yichengsun/Room-Mapping-Vehicle/CAD Files/3D Printing Schematics/encoder_hub.stl

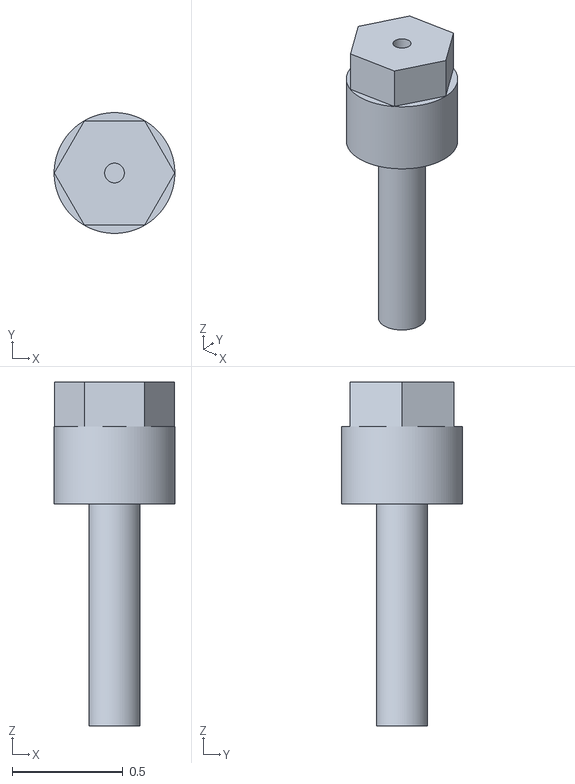
[picture p35: CAD file, 2015-08-05]
CAD Files/3D Printing Schematics/encoder_hub.stl
0.544 x 0.544 x 1.55
