yichengsun/Room-Mapping-Vehicle/CAD Files/Circuit Schematics/H_bridge.asc

A1: and
A2: and
A3: inv
M1: pmos
M2: pmos
M3: nmos
M4: nmos
R1: res; 6K
R2: res; 6K
U1: LT1017
U2: LT1017
Named nets: MOTOR+, MOTOR-, 7.2V, 0, 1.5V, PWM, DIR
