yichengsun/Room-Mapping-Vehicle/CAD Files/EAGLE Schematics/car.sch

## EAGLE design CAD Files/EAGLE Schematics/car.sch (2015-08-06)

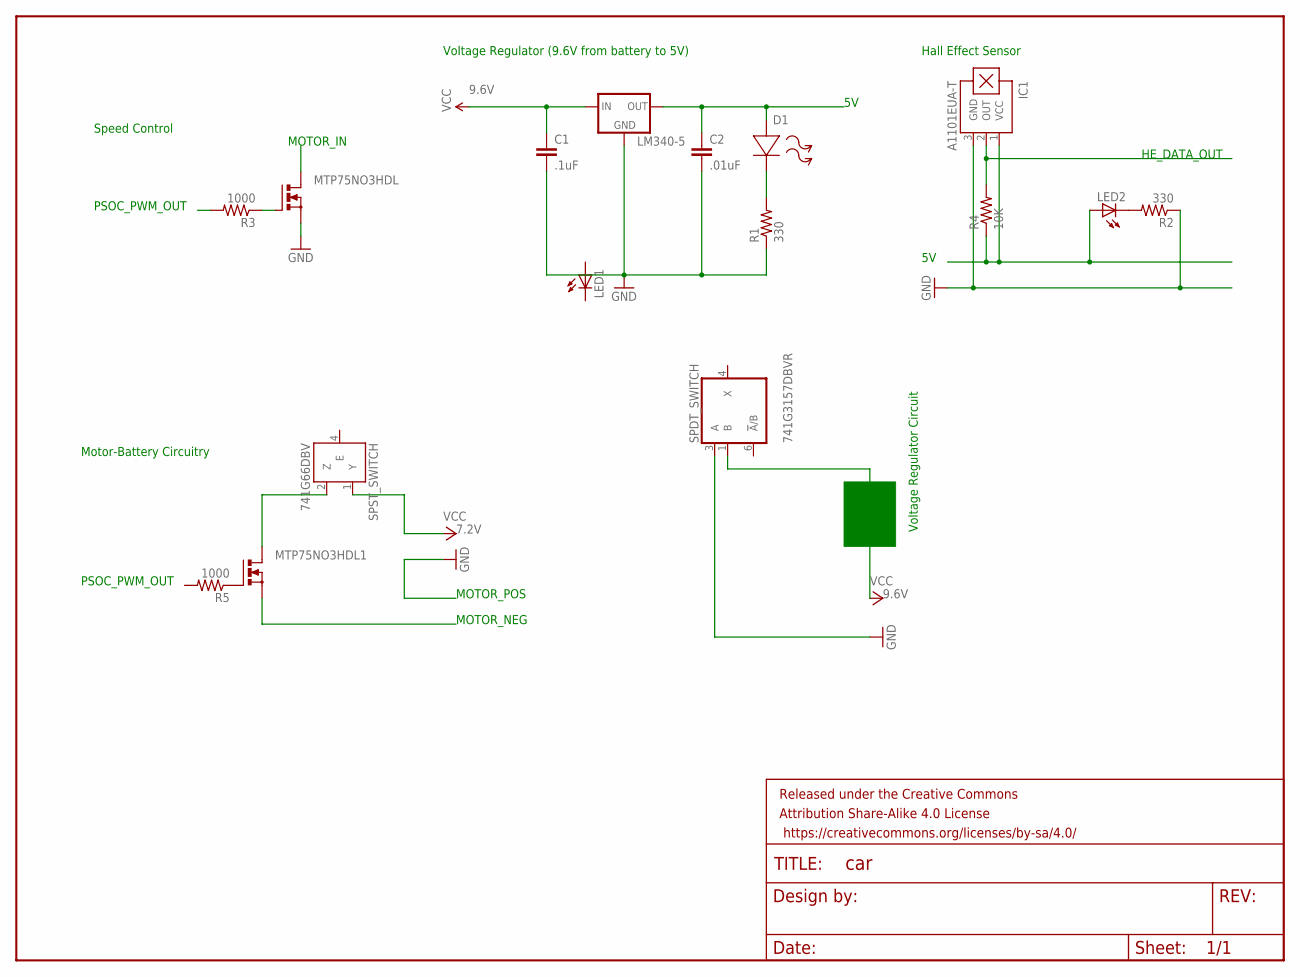
[picture p36: schematic car.sch]

Parts:
C1: .1uF; 0402-CAP
C2: .01uF; 0402-CAP
D1: LED; R0805
FRAME1: FRAME-LETTER; CREATIVE_COMMONS
IC1: A1101EUA-T; SOT23-W
LED1, LED2: LED_E; LED_1206
LM340-5: V_REG_78XX-TO-220; TO-220-ALT
MTP75NO3HDL, MTP75NO3HDL1: PMOSFET_NTO220BH; TO220BH
R1, R2: 330; 0402-RES
R3, R5: 1000; 0402-RES
R4: 10K; 0204V
SPDT_SWITCH: 741G3157DBVR; DBV_R-PDSO-G6
SPST_SWITCH: 741G66DBV; SOT23-5

Connections:
GND: C1.2, C2.2, IC1.3 (GND), LM340-5.GND, MTP75NO3HDL.S, R1.1, R2.1, SPDT_SWITCH.3 (A)
unnamed: IC1.1 (VCC), LED2.A, R4.1
unnamed: D1.2 (-), R1.2
unnamed: IC1.2 (OUT), R4.2
unnamed: C2.1, D1.1 (+), LM340-5.OUT
unnamed: LED2.C, R2.2
unnamed: MTP75NO3HDL.G, R3.1
unnamed: MTP75NO3HDL1.D, SPST_SWITCH.2 (Z)
unnamed: MTP75NO3HDL1.G, R5.1
VCC: C1.1, LM340-5.IN, SPST_SWITCH.1 (Y)

Notes on the sheet:
Voltage Regulator (9.6V from battery to 5V)
HE_DATA_OUT
Hall Effect Sensor
MOTOR_IN
PSOC_PWM_OUT
Speed Control
MOTOR_POS
MOTOR_NEG
Motor-Battery Circuitry
Voltage Regulator Circuit
