yichengsun/Room-Mapping-Vehicle/PSOC Microprocessor Code/Car.cydsn/codegentemp/MOTOR_PWM.c

/*******************************************************************************
* File Name: MOTOR_PWM.c
* Version 3.10
*
* Description:
*  The PWM User Module consist of an 8 or 16-bit counter with two 8 or 16-bit
*  comparitors. Each instance of this user module is capable of generating
*  two PWM outputs with the same period. The pulse width is selectable between
*  1 and 255/65535. The period is selectable between 2 and 255/65536 clocks.
*  The compare value output may be configured to be active when the present
*  counter is less than or less than/equal to the compare value.
*  A terminal count output is also provided. It generates a pulse one clock
*  width wide when the counter is equal to zero.
*
* Note:
*
*******************************************************************************
* Copyright 2008-2014, Cypress Semiconductor Corporation.  All rights reserved.
* You may use this file only in accordance with the license, terms, conditions,
* disclaimers, and limitations in the end user license agreement accompanying
* the software package with which this file was provided.
********************************************************************************/

#include "MOTOR_PWM.h"

/* Error message for removed <resource> through optimization */
#ifdef MOTOR_PWM_PWMUDB_genblk1_ctrlreg__REMOVED
    #error PWM_v3_10 detected with a constant 0 for the enable or \
         constant 1 for reset. This will prevent the component from operating.
#endif /* MOTOR_PWM_PWMUDB_genblk1_ctrlreg__REMOVED */

uint8 MOTOR_PWM_initVar = 0u;


/*******************************************************************************
* Function Name: MOTOR_PWM_Start
********************************************************************************
*
* Summary:
*  The start function initializes the pwm with the default values, the
*  enables the counter to begin counting.  It does not enable interrupts,
*  the EnableInt command should be called if interrupt generation is required.
*
* Parameters:
*  None
*
* Return:
*  None
*
* Global variables:
*  MOTOR_PWM_initVar: Is modified when this function is called for the
*   first time. Is used to ensure that initialization happens only once.
*
*******************************************************************************/
void MOTOR_PWM_Start(void) 
{
    /* If not Initialized then initialize all required hardware and software */
    if(MOTOR_PWM_initVar == 0u)
    {
        MOTOR_PWM_Init();
        MOTOR_PWM_initVar = 1u;
    }
    MOTOR_PWM_Enable();

}


/*******************************************************************************
* Function Name: MOTOR_PWM_Init
********************************************************************************
*
* Summary:
*  Initialize component's parameters to the parameters set by user in the
*  customizer of the component placed onto schematic. Usually called in
*  MOTOR_PWM_Start().
*
* Parameters:
*  None
*
* Return:
*  None
*
*******************************************************************************/
void MOTOR_PWM_Init(void) 
{
    #if (MOTOR_PWM_UsingFixedFunction || MOTOR_PWM_UseControl)
        uint8 ctrl;
    #endif /* (MOTOR_PWM_UsingFixedFunction || MOTOR_PWM_UseControl) */

    #if(!MOTOR_PWM_UsingFixedFunction)
        #if(MOTOR_PWM_UseStatus)
            /* Interrupt State Backup for Critical Region*/
            uint8 MOTOR_PWM_interruptState;
        #endif /* (MOTOR_PWM_UseStatus) */
    #endif /* (!MOTOR_PWM_UsingFixedFunction) */

    #if (MOTOR_PWM_UsingFixedFunction)
        /* You are allowed to write the compare value (FF only) */
        MOTOR_PWM_CONTROL |= MOTOR_PWM_CFG0_MODE;
        #if (MOTOR_PWM_DeadBand2_4)
            MOTOR_PWM_CONTROL |= MOTOR_PWM_CFG0_DB;
        #endif /* (MOTOR_PWM_DeadBand2_4) */

        ctrl = MOTOR_PWM_CONTROL3 & ((uint8 )(~MOTOR_PWM_CTRL_CMPMODE1_MASK));
        MOTOR_PWM_CONTROL3 = ctrl | MOTOR_PWM_DEFAULT_COMPARE1_MODE;

         /* Clear and Set SYNCTC and SYNCCMP bits of RT1 register */
        MOTOR_PWM_RT1 &= ((uint8)(~MOTOR_PWM_RT1_MASK));
        MOTOR_PWM_RT1 |= MOTOR_PWM_SYNC;

        /*Enable DSI Sync all all inputs of the PWM*/
        MOTOR_PWM_RT1 &= ((uint8)(~MOTOR_PWM_SYNCDSI_MASK));
        MOTOR_PWM_RT1 |= MOTOR_PWM_SYNCDSI_EN;

    #elif (MOTOR_PWM_UseControl)
        /* Set the default compare mode defined in the parameter */
        ctrl = MOTOR_PWM_CONTROL & ((uint8)(~MOTOR_PWM_CTRL_CMPMODE2_MASK)) &
                ((uint8)(~MOTOR_PWM_CTRL_CMPMODE1_MASK));
        MOTOR_PWM_CONTROL = ctrl | MOTOR_PWM_DEFAULT_COMPARE2_MODE |
                                   MOTOR_PWM_DEFAULT_COMPARE1_MODE;
    #endif /* (MOTOR_PWM_UsingFixedFunction) */

    #if (!MOTOR_PWM_UsingFixedFunction)
        #if (MOTOR_PWM_Resolution == 8)
            /* Set FIFO 0 to 1 byte register for period*/
            MOTOR_PWM_AUX_CONTROLDP0 |= (MOTOR_PWM_AUX_CTRL_FIFO0_CLR);
        #else /* (MOTOR_PWM_Resolution == 16)*/
            /* Set FIFO 0 to 1 byte register for period */
            MOTOR_PWM_AUX_CONTROLDP0 |= (MOTOR_PWM_AUX_CTRL_FIFO0_CLR);
            MOTOR_PWM_AUX_CONTROLDP1 |= (MOTOR_PWM_AUX_CTRL_FIFO0_CLR);
        #endif /* (MOTOR_PWM_Resolution == 8) */

        MOTOR_PWM_WriteCounter(MOTOR_PWM_INIT_PERIOD_VALUE);
    #endif /* (!MOTOR_PWM_UsingFixedFunction) */

    MOTOR_PWM_WritePeriod(MOTOR_PWM_INIT_PERIOD_VALUE);

        #if (MOTOR_PWM_UseOneCompareMode)
            MOTOR_PWM_WriteCompare(MOTOR_PWM_INIT_COMPARE_VALUE1);
        #else
            MOTOR_PWM_WriteCompare1(MOTOR_PWM_INIT_COMPARE_VALUE1);
            MOTOR_PWM_WriteCompare2(MOTOR_PWM_INIT_COMPARE_VALUE2);
        #endif /* (MOTOR_PWM_UseOneCompareMode) */

        #if (MOTOR_PWM_KillModeMinTime)
            MOTOR_PWM_WriteKillTime(MOTOR_PWM_MinimumKillTime);
        #endif /* (MOTOR_PWM_KillModeMinTime) */

        #if (MOTOR_PWM_DeadBandUsed)
            MOTOR_PWM_WriteDeadTime(MOTOR_PWM_INIT_DEAD_TIME);
        #endif /* (MOTOR_PWM_DeadBandUsed) */

    #if (MOTOR_PWM_UseStatus || MOTOR_PWM_UsingFixedFunction)
        MOTOR_PWM_SetInterruptMode(MOTOR_PWM_INIT_INTERRUPTS_MODE);
    #endif /* (MOTOR_PWM_UseStatus || MOTOR_PWM_UsingFixedFunction) */

    #if (MOTOR_PWM_UsingFixedFunction)
        /* Globally Enable the Fixed Function Block chosen */
        MOTOR_PWM_GLOBAL_ENABLE |= MOTOR_PWM_BLOCK_EN_MASK;
        /* Set the Interrupt source to come from the status register */
        MOTOR_PWM_CONTROL2 |= MOTOR_PWM_CTRL2_IRQ_SEL;
    #else
        #if(MOTOR_PWM_UseStatus)

            /* CyEnterCriticalRegion and CyExitCriticalRegion are used to mark following region critical*/
            /* Enter Critical Region*/
            MOTOR_PWM_interruptState = CyEnterCriticalSection();
            /* Use the interrupt output of the status register for IRQ output */
            MOTOR_PWM_STATUS_AUX_CTRL |= MOTOR_PWM_STATUS_ACTL_INT_EN_MASK;

             /* Exit Critical Region*/
            CyExitCriticalSection(MOTOR_PWM_interruptState);

            /* Clear the FIFO to enable the MOTOR_PWM_STATUS_FIFOFULL
                   bit to be set on FIFO full. */
            MOTOR_PWM_ClearFIFO();
        #endif /* (MOTOR_PWM_UseStatus) */
    #endif /* (MOTOR_PWM_UsingFixedFunction) */
}


/*******************************************************************************
* Function Name: MOTOR_PWM_Enable
********************************************************************************
*
* Summary:
*  Enables the PWM block operation
*
* Parameters:
*  None
*
* Return:
*  None
*
* Side Effects:
*  This works only if software enable mode is chosen
*
*******************************************************************************/
void MOTOR_PWM_Enable(void) 
{
    /* Globally Enable the Fixed Function Block chosen */
    #if (MOTOR_PWM_UsingFixedFunction)
        MOTOR_PWM_GLOBAL_ENABLE |= MOTOR_PWM_BLOCK_EN_MASK;
        MOTOR_PWM_GLOBAL_STBY_ENABLE |= MOTOR_PWM_BLOCK_STBY_EN_MASK;
    #endif /* (MOTOR_PWM_UsingFixedFunction) */

    /* Enable the PWM from the control register  */
    #if (MOTOR_PWM_UseControl || MOTOR_PWM_UsingFixedFunction)
        MOTOR_PWM_CONTROL |= MOTOR_PWM_CTRL_ENABLE;
    #endif /* (MOTOR_PWM_UseControl || MOTOR_PWM_UsingFixedFunction) */
}


/*******************************************************************************
* Function Name: MOTOR_PWM_Stop
********************************************************************************
*
* Summary:
*  The stop function halts the PWM, but does not change any modes or disable
*  interrupts.
*
* Parameters:
*  None
*
* Return:
*  None
*
* Side Effects:
*  If the Enable mode is set to Hardware only then this function
*  has no effect on the operation of the PWM
*
*******************************************************************************/
void MOTOR_PWM_Stop(void) 
{
    #if (MOTOR_PWM_UseControl || MOTOR_PWM_UsingFixedFunction)
        MOTOR_PWM_CONTROL &= ((uint8)(~MOTOR_PWM_CTRL_ENABLE));
    #endif /* (MOTOR_PWM_UseControl || MOTOR_PWM_UsingFixedFunction) */

    /* Globally disable the Fixed Function Block chosen */
    #if (MOTOR_PWM_UsingFixedFunction)
        MOTOR_PWM_GLOBAL_ENABLE &= ((uint8)(~MOTOR_PWM_BLOCK_EN_MASK));
        MOTOR_PWM_GLOBAL_STBY_ENABLE &= ((uint8)(~MOTOR_PWM_BLOCK_STBY_EN_MASK));
    #endif /* (MOTOR_PWM_UsingFixedFunction) */
}

#if (MOTOR_PWM_UseOneCompareMode)
    #if (MOTOR_PWM_CompareMode1SW)


        /*******************************************************************************
        * Function Name: MOTOR_PWM_SetCompareMode
        ********************************************************************************
        *
        * Summary:
        *  This function writes the Compare Mode for the pwm output when in Dither mode,
        *  Center Align Mode or One Output Mode.
        *
        * Parameters:
        *  comparemode:  The new compare mode for the PWM output. Use the compare types
        *                defined in the H file as input arguments.
        *
        * Return:
        *  None
        *
        *******************************************************************************/
        void MOTOR_PWM_SetCompareMode(uint8 comparemode) 
        {
            #if(MOTOR_PWM_UsingFixedFunction)

                #if(0 != MOTOR_PWM_CTRL_CMPMODE1_SHIFT)
                    uint8 comparemodemasked = ((uint8)((uint8)comparemode << MOTOR_PWM_CTRL_CMPMODE1_SHIFT));
                #else
                    uint8 comparemodemasked = comparemode;
                #endif /* (0 != MOTOR_PWM_CTRL_CMPMODE1_SHIFT) */

                MOTOR_PWM_CONTROL3 &= ((uint8)(~MOTOR_PWM_CTRL_CMPMODE1_MASK)); /*Clear Existing Data */
                MOTOR_PWM_CONTROL3 |= comparemodemasked;

            #elif (MOTOR_PWM_UseControl)

                #if(0 != MOTOR_PWM_CTRL_CMPMODE1_SHIFT)
                    uint8 comparemode1masked = ((uint8)((uint8)comparemode << MOTOR_PWM_CTRL_CMPMODE1_SHIFT)) &
                                                MOTOR_PWM_CTRL_CMPMODE1_MASK;
                #else
                    uint8 comparemode1masked = comparemode & MOTOR_PWM_CTRL_CMPMODE1_MASK;
                #endif /* (0 != MOTOR_PWM_CTRL_CMPMODE1_SHIFT) */

                #if(0 != MOTOR_PWM_CTRL_CMPMODE2_SHIFT)
                    uint8 comparemode2masked = ((uint8)((uint8)comparemode << MOTOR_PWM_CTRL_CMPMODE2_SHIFT)) &
                                               MOTOR_PWM_CTRL_CMPMODE2_MASK;
                #else
                    uint8 comparemode2masked = comparemode & MOTOR_PWM_CTRL_CMPMODE2_MASK;
                #endif /* (0 != MOTOR_PWM_CTRL_CMPMODE2_SHIFT) */

                /*Clear existing mode */
                MOTOR_PWM_CONTROL &= ((uint8)(~(MOTOR_PWM_CTRL_CMPMODE1_MASK |
                                            MOTOR_PWM_CTRL_CMPMODE2_MASK)));
                MOTOR_PWM_CONTROL |= (comparemode1masked | comparemode2masked);

            #else
                uint8 temp = comparemode;
            #endif /* (MOTOR_PWM_UsingFixedFunction) */
        }
    #endif /* MOTOR_PWM_CompareMode1SW */

#else /* UseOneCompareMode */

    #if (MOTOR_PWM_CompareMode1SW)


        /*******************************************************************************
        * Function Name: MOTOR_PWM_SetCompareMode1
        ********************************************************************************
        *
        * Summary:
        *  This function writes the Compare Mode for the pwm or pwm1 output
        *
        * Parameters:
        *  comparemode:  The new compare mode for the PWM output. Use the compare types
        *                defined in the H file as input arguments.
        *
        * Return:
        *  None
        *
        *******************************************************************************/
        void MOTOR_PWM_SetCompareMode1(uint8 comparemode) 
        {
            #if(0 != MOTOR_PWM_CTRL_CMPMODE1_SHIFT)
                uint8 comparemodemasked = ((uint8)((uint8)comparemode << MOTOR_PWM_CTRL_CMPMODE1_SHIFT)) &
                                           MOTOR_PWM_CTRL_CMPMODE1_MASK;
            #else
                uint8 comparemodemasked = comparemode & MOTOR_PWM_CTRL_CMPMODE1_MASK;
            #endif /* (0 != MOTOR_PWM_CTRL_CMPMODE1_SHIFT) */

            #if (MOTOR_PWM_UseControl)
                MOTOR_PWM_CONTROL &= ((uint8)(~MOTOR_PWM_CTRL_CMPMODE1_MASK)); /*Clear existing mode */
                MOTOR_PWM_CONTROL |= comparemodemasked;
            #endif /* (MOTOR_PWM_UseControl) */
        }
    #endif /* MOTOR_PWM_CompareMode1SW */

#if (MOTOR_PWM_CompareMode2SW)


    /*******************************************************************************
    * Function Name: MOTOR_PWM_SetCompareMode2
    ********************************************************************************
    *
    * Summary:
    *  This function writes the Compare Mode for the pwm or pwm2 output
    *
    * Parameters:
    *  comparemode:  The new compare mode for the PWM output. Use the compare types
    *                defined in the H file as input arguments.
    *
    * Return:
    *  None
    *
    *******************************************************************************/
    void MOTOR_PWM_SetCompareMode2(uint8 comparemode) 
    {

        #if(0 != MOTOR_PWM_CTRL_CMPMODE2_SHIFT)
            uint8 comparemodemasked = ((uint8)((uint8)comparemode << MOTOR_PWM_CTRL_CMPMODE2_SHIFT)) &
                                                 MOTOR_PWM_CTRL_CMPMODE2_MASK;
        #else
            uint8 comparemodemasked = comparemode & MOTOR_PWM_CTRL_CMPMODE2_MASK;
        #endif /* (0 != MOTOR_PWM_CTRL_CMPMODE2_SHIFT) */

        #if (MOTOR_PWM_UseControl)
            MOTOR_PWM_CONTROL &= ((uint8)(~MOTOR_PWM_CTRL_CMPMODE2_MASK)); /*Clear existing mode */
            MOTOR_PWM_CONTROL |= comparemodemasked;
        #endif /* (MOTOR_PWM_UseControl) */
    }
    #endif /*MOTOR_PWM_CompareMode2SW */

#endif /* UseOneCompareMode */


#if (!MOTOR_PWM_UsingFixedFunction)


    /*******************************************************************************
    * Function Name: MOTOR_PWM_WriteCounter
    ********************************************************************************
    *
    * Summary:
    *  Writes a new counter value directly to the counter register. This will be
    *  implemented for that currently running period and only that period. This API
    *  is valid only for UDB implementation and not available for fixed function
    *  PWM implementation.
    *
    * Parameters:
    *  counter:  The period new period counter value.
    *
    * Return:
    *  None
    *
    * Side Effects:
    *  The PWM Period will be reloaded when a counter value will be a zero
    *
    *******************************************************************************/
    void MOTOR_PWM_WriteCounter(uint16 counter) \
                                       
    {
        CY_SET_REG16(MOTOR_PWM_COUNTER_LSB_PTR, counter);
    }


    /*******************************************************************************
    * Function Name: MOTOR_PWM_ReadCounter
    ********************************************************************************
    *
    * Summary:
    *  This function returns the current value of the counter.  It doesn't matter
    *  if the counter is enabled or running.
    *
    * Parameters:
    *  None
    *
    * Return:
    *  The current value of the counter.
    *
    *******************************************************************************/
    uint16 MOTOR_PWM_ReadCounter(void) 
    {
        /* Force capture by reading Accumulator */
        /* Must first do a software capture to be able to read the counter */
        /* It is up to the user code to make sure there isn't already captured data in the FIFO */
          (void)CY_GET_REG8(MOTOR_PWM_COUNTERCAP_LSB_PTR_8BIT);

        /* Read the data from the FIFO */
        return (CY_GET_REG16(MOTOR_PWM_CAPTURE_LSB_PTR));
    }

    #if (MOTOR_PWM_UseStatus)


        /*******************************************************************************
        * Function Name: MOTOR_PWM_ClearFIFO
        ********************************************************************************
        *
        * Summary:
        *  This function clears all capture data from the capture FIFO
        *
        * Parameters:
        *  None
        *
        * Return:
        *  None
        *
        *******************************************************************************/
        void MOTOR_PWM_ClearFIFO(void) 
        {
            while(0u != (MOTOR_PWM_ReadStatusRegister() & MOTOR_PWM_STATUS_FIFONEMPTY))
            {
                (void)MOTOR_PWM_ReadCapture();
            }
        }

    #endif /* MOTOR_PWM_UseStatus */

#endif /* !MOTOR_PWM_UsingFixedFunction */


/*******************************************************************************
* Function Name: MOTOR_PWM_WritePeriod
********************************************************************************
*
* Summary:
*  This function is used to change the period of the counter.  The new period
*  will be loaded the next time terminal count is detected.
*
* Parameters:
*  period:  Period value. May be between 1 and (2^Resolution)-1.  A value of 0
*           will result in the counter remaining at zero.
*
* Return:
*  None
*
*******************************************************************************/
void MOTOR_PWM_WritePeriod(uint16 period) 
{
    #if(MOTOR_PWM_UsingFixedFunction)
        CY_SET_REG16(MOTOR_PWM_PERIOD_LSB_PTR, (uint16)period);
    #else
        CY_SET_REG16(MOTOR_PWM_PERIOD_LSB_PTR, period);
    #endif /* (MOTOR_PWM_UsingFixedFunction) */
}

#if (MOTOR_PWM_UseOneCompareMode)


    /*******************************************************************************
    * Function Name: MOTOR_PWM_WriteCompare
    ********************************************************************************
    *
    * Summary:
    *  This funtion is used to change the compare1 value when the PWM is in Dither
    *  mode. The compare output will reflect the new value on the next UDB clock.
    *  The compare output will be driven high when the present counter value is
    *  compared to the compare value based on the compare mode defined in
    *  Dither Mode.
    *
    * Parameters:
    *  compare:  New compare value.
    *
    * Return:
    *  None
    *
    * Side Effects:
    *  This function is only available if the PWM mode parameter is set to
    *  Dither Mode, Center Aligned Mode or One Output Mode
    *
    *******************************************************************************/
    void MOTOR_PWM_WriteCompare(uint16 compare) \
                                       
    {
        #if(MOTOR_PWM_UsingFixedFunction)
            CY_SET_REG16(MOTOR_PWM_COMPARE1_LSB_PTR, (uint16)compare);
        #else
            CY_SET_REG16(MOTOR_PWM_COMPARE1_LSB_PTR, compare);
        #endif /* (MOTOR_PWM_UsingFixedFunction) */

        #if (MOTOR_PWM_PWMMode == MOTOR_PWM__B_PWM__DITHER)
            #if(MOTOR_PWM_UsingFixedFunction)
                CY_SET_REG16(MOTOR_PWM_COMPARE2_LSB_PTR, (uint16)(compare + 1u));
            #else
                CY_SET_REG16(MOTOR_PWM_COMPARE2_LSB_PTR, (compare + 1u));
            #endif /* (MOTOR_PWM_UsingFixedFunction) */
        #endif /* (MOTOR_PWM_PWMMode == MOTOR_PWM__B_PWM__DITHER) */
    }


#else


    /*******************************************************************************
    * Function Name: MOTOR_PWM_WriteCompare1
    ********************************************************************************
    *
    * Summary:
    *  This funtion is used to change the compare1 value.  The compare output will
    *  reflect the new value on the next UDB clock.  The compare output will be
    *  driven high when the present counter value is less than or less than or
    *  equal to the compare register, depending on the mode.
    *
    * Parameters:
    *  compare:  New compare value.
    *
    * Return:
    *  None
    *
    *******************************************************************************/
    void MOTOR_PWM_WriteCompare1(uint16 compare) \
                                        
    {
        #if(MOTOR_PWM_UsingFixedFunction)
            CY_SET_REG16(MOTOR_PWM_COMPARE1_LSB_PTR, (uint16)compare);
        #else
            CY_SET_REG16(MOTOR_PWM_COMPARE1_LSB_PTR, compare);
        #endif /* (MOTOR_PWM_UsingFixedFunction) */
    }


    /*******************************************************************************
    * Function Name: MOTOR_PWM_WriteCompare2
    ********************************************************************************
    *
    * Summary:
    *  This funtion is used to change the compare value, for compare1 output.
    *  The compare output will reflect the new value on the next UDB clock.
    *  The compare output will be driven high when the present counter value is
    *  less than or less than or equal to the compare register, depending on the
    *  mode.
    *
    * Parameters:
    *  compare:  New compare value.
    *
    * Return:
    *  None
    *
    *******************************************************************************/
    void MOTOR_PWM_WriteCompare2(uint16 compare) \
                                        
    {
        #if(MOTOR_PWM_UsingFixedFunction)
            CY_SET_REG16(MOTOR_PWM_COMPARE2_LSB_PTR, compare);
        #else
            CY_SET_REG16(MOTOR_PWM_COMPARE2_LSB_PTR, compare);
        #endif /* (MOTOR_PWM_UsingFixedFunction) */
    }
#endif /* UseOneCompareMode */

#if (MOTOR_PWM_DeadBandUsed)


    /*******************************************************************************
    * Function Name: MOTOR_PWM_WriteDeadTime
    ********************************************************************************
    *
    * Summary:
    *  This function writes the dead-band counts to the corresponding register
    *
    * Parameters:
    *  deadtime:  Number of counts for dead time
    *
    * Return:
    *  None
    *
    *******************************************************************************/
    void MOTOR_PWM_WriteDeadTime(uint8 deadtime) 
    {
        /* If using the Dead Band 1-255 mode then just write the register */
        #if(!MOTOR_PWM_DeadBand2_4)
            CY_SET_REG8(MOTOR_PWM_DEADBAND_COUNT_PTR, deadtime);
        #else
            /* Otherwise the data has to be masked and offset */
            /* Clear existing data */
            MOTOR_PWM_DEADBAND_COUNT &= ((uint8)(~MOTOR_PWM_DEADBAND_COUNT_MASK));

            /* Set new dead time */
            #if(MOTOR_PWM_DEADBAND_COUNT_SHIFT)
                MOTOR_PWM_DEADBAND_COUNT |= ((uint8)((uint8)deadtime << MOTOR_PWM_DEADBAND_COUNT_SHIFT)) &
                                                    MOTOR_PWM_DEADBAND_COUNT_MASK;
            #else
                MOTOR_PWM_DEADBAND_COUNT |= deadtime & MOTOR_PWM_DEADBAND_COUNT_MASK;
            #endif /* (MOTOR_PWM_DEADBAND_COUNT_SHIFT) */

        #endif /* (!MOTOR_PWM_DeadBand2_4) */
    }


    /*******************************************************************************
    * Function Name: MOTOR_PWM_ReadDeadTime
    ********************************************************************************
    *
    * Summary:
    *  This function reads the dead-band counts from the corresponding register
    *
    * Parameters:
    *  None
    *
    * Return:
    *  Dead Band Counts
    *
    *******************************************************************************/
    uint8 MOTOR_PWM_ReadDeadTime(void) 
    {
        /* If using the Dead Band 1-255 mode then just read the register */
        #if(!MOTOR_PWM_DeadBand2_4)
            return (CY_GET_REG8(MOTOR_PWM_DEADBAND_COUNT_PTR));
        #else

            /* Otherwise the data has to be masked and offset */
            #if(MOTOR_PWM_DEADBAND_COUNT_SHIFT)
                return ((uint8)(((uint8)(MOTOR_PWM_DEADBAND_COUNT & MOTOR_PWM_DEADBAND_COUNT_MASK)) >>
                                                                           MOTOR_PWM_DEADBAND_COUNT_SHIFT));
            #else
                return (MOTOR_PWM_DEADBAND_COUNT & MOTOR_PWM_DEADBAND_COUNT_MASK);
            #endif /* (MOTOR_PWM_DEADBAND_COUNT_SHIFT) */
        #endif /* (!MOTOR_PWM_DeadBand2_4) */
    }
#endif /* DeadBandUsed */

#if (MOTOR_PWM_UseStatus || MOTOR_PWM_UsingFixedFunction)


    /*******************************************************************************
    * Function Name: MOTOR_PWM_SetInterruptMode
    ********************************************************************************
    *
    * Summary:
    *  This function configures the interrupts mask control of theinterrupt
    *  source status register.
    *
    * Parameters:
    *  uint8 interruptMode: Bit field containing the interrupt sources enabled
    *
    * Return:
    *  None
    *
    *******************************************************************************/
    void MOTOR_PWM_SetInterruptMode(uint8 interruptMode) 
    {
        CY_SET_REG8(MOTOR_PWM_STATUS_MASK_PTR, interruptMode);
    }


    /*******************************************************************************
    * Function Name: MOTOR_PWM_ReadStatusRegister
    ********************************************************************************
    *
    * Summary:
    *  This function returns the current state of the status register.
    *
    * Parameters:
    *  None
    *
    * Return:
    *  uint8 : Current status register value. The status register bits are:
    *  [7:6] : Unused(0)
    *  [5]   : Kill event output
    *  [4]   : FIFO not empty
    *  [3]   : FIFO full
    *  [2]   : Terminal count
    *  [1]   : Compare output 2
    *  [0]   : Compare output 1
    *
    *******************************************************************************/
    uint8 MOTOR_PWM_ReadStatusRegister(void) 
    {
        return (CY_GET_REG8(MOTOR_PWM_STATUS_PTR));
    }

#endif /* (MOTOR_PWM_UseStatus || MOTOR_PWM_UsingFixedFunction) */


#if (MOTOR_PWM_UseControl)


    /*******************************************************************************
    * Function Name: MOTOR_PWM_ReadControlRegister
    ********************************************************************************
    *
    * Summary:
    *  Returns the current state of the control register. This API is available
    *  only if the control register is not removed.
    *
    * Parameters:
    *  None
    *
    * Return:
    *  uint8 : Current control register value
    *
    *******************************************************************************/
    uint8 MOTOR_PWM_ReadControlRegister(void) 
    {
        uint8 result;

        result = CY_GET_REG8(MOTOR_PWM_CONTROL_PTR);
        return (result);
    }


    /*******************************************************************************
    * Function Name: MOTOR_PWM_WriteControlRegister
    ********************************************************************************
    *
    * Summary:
    *  Sets the bit field of the control register. This API is available only if
    *  the control register is not removed.
    *
    * Parameters:
    *  uint8 control: Control register bit field, The status register bits are:
    *  [7]   : PWM Enable
    *  [6]   : Reset
    *  [5:3] : Compare Mode2
    *  [2:0] : Compare Mode2
    *
    * Return:
    *  None
    *
    *******************************************************************************/
    void MOTOR_PWM_WriteControlRegister(uint8 control) 
    {
        CY_SET_REG8(MOTOR_PWM_CONTROL_PTR, control);
    }

#endif /* (MOTOR_PWM_UseControl) */


#if (!MOTOR_PWM_UsingFixedFunction)


    /*******************************************************************************
    * Function Name: MOTOR_PWM_ReadCapture
    ********************************************************************************
    *
    * Summary:
    *  Reads the capture value from the capture FIFO.
    *
    * Parameters:
    *  None
    *
    * Return:
    *  uint8/uint16: The current capture value
    *
    *******************************************************************************/
    uint16 MOTOR_PWM_ReadCapture(void) 
    {
        return (CY_GET_REG16(MOTOR_PWM_CAPTURE_LSB_PTR));
    }

#endif /* (!MOTOR_PWM_UsingFixedFunction) */


#if (MOTOR_PWM_UseOneCompareMode)


    /*******************************************************************************
    * Function Name: MOTOR_PWM_ReadCompare
    ********************************************************************************
    *
    * Summary:
    *  Reads the compare value for the compare output when the PWM Mode parameter is
    *  set to Dither mode, Center Aligned mode, or One Output mode.
    *
    * Parameters:
    *  None
    *
    * Return:
    *  uint8/uint16: Current compare value
    *
    *******************************************************************************/
    uint16 MOTOR_PWM_ReadCompare(void) 
    {
        #if(MOTOR_PWM_UsingFixedFunction)
            return ((uint16)CY_GET_REG16(MOTOR_PWM_COMPARE1_LSB_PTR));
        #else
            return (CY_GET_REG16(MOTOR_PWM_COMPARE1_LSB_PTR));
        #endif /* (MOTOR_PWM_UsingFixedFunction) */
    }

#else


    /*******************************************************************************
    * Function Name: MOTOR_PWM_ReadCompare1
    ********************************************************************************
    *
    * Summary:
    *  Reads the compare value for the compare1 output.
    *
    * Parameters:
    *  None
    *
    * Return:
    *  uint8/uint16: Current compare value.
    *
    *******************************************************************************/
    uint16 MOTOR_PWM_ReadCompare1(void) 
    {
        return (CY_GET_REG16(MOTOR_PWM_COMPARE1_LSB_PTR));
    }


    /*******************************************************************************
    * Function Name: MOTOR_PWM_ReadCompare2
    ********************************************************************************
    *
    * Summary:
    *  Reads the compare value for the compare2 output.
    *
    * Parameters:
    *  None
    *
    * Return:
    *  uint8/uint16: Current compare value.
    *
    *******************************************************************************/
    uint16 MOTOR_PWM_ReadCompare2(void) 
    {
        return (CY_GET_REG16(MOTOR_PWM_COMPARE2_LSB_PTR));
    }

#endif /* (MOTOR_PWM_UseOneCompareMode) */


/*******************************************************************************
* Function Name: MOTOR_PWM_ReadPeriod
********************************************************************************
*
* Summary:
*  Reads the period value used by the PWM hardware.
*
* Parameters:
*  None
*
* Return:
*  uint8/16: Period value
*
*******************************************************************************/
uint16 MOTOR_PWM_ReadPeriod(void) 
{
    #if(MOTOR_PWM_UsingFixedFunction)
        return ((uint16)CY_GET_REG16(MOTOR_PWM_PERIOD_LSB_PTR));
    #else
        return (CY_GET_REG16(MOTOR_PWM_PERIOD_LSB_PTR));
    #endif /* (MOTOR_PWM_UsingFixedFunction) */
}

#if ( MOTOR_PWM_KillModeMinTime)


    /*******************************************************************************
    * Function Name: MOTOR_PWM_WriteKillTime
    ********************************************************************************
    *
    * Summary:
    *  Writes the kill time value used by the hardware when the Kill Mode
    *  is set to Minimum Time.
    *
    * Parameters:
    *  uint8: Minimum Time kill counts
    *
    * Return:
    *  None
    *
    *******************************************************************************/
    void MOTOR_PWM_WriteKillTime(uint8 killtime) 
    {
        CY_SET_REG8(MOTOR_PWM_KILLMODEMINTIME_PTR, killtime);
    }


    /*******************************************************************************
    * Function Name: MOTOR_PWM_ReadKillTime
    ********************************************************************************
    *
    * Summary:
    *  Reads the kill time value used by the hardware when the Kill Mode is set
    *  to Minimum Time.
    *
    * Parameters:
    *  None
    *
    * Return:
    *  uint8: The current Minimum Time kill counts
    *
    *******************************************************************************/
    uint8 MOTOR_PWM_ReadKillTime(void) 
    {
        return (CY_GET_REG8(MOTOR_PWM_KILLMODEMINTIME_PTR));
    }

#endif /* ( MOTOR_PWM_KillModeMinTime) */

/* [] END OF FILE */
