yichengsun/Room-Mapping-Vehicle/PSOC Microprocessor Code/Car.cydsn/codegentemp/UPDATE_STEER_ISR.h

/*******************************************************************************
* File Name: UPDATE_STEER_ISR.h
* Version 1.70
*
*  Description:
*   Provides the function definitions for the Interrupt Controller.
*
*
********************************************************************************
* Copyright 2008-2012, Cypress Semiconductor Corporation.  All rights reserved.
* You may use this file only in accordance with the license, terms, conditions, 
* disclaimers, and limitations in the end user license agreement accompanying 
* the software package with which this file was provided.
*******************************************************************************/

#if !defined(CY_ISR_UPDATE_STEER_ISR_H)
#define CY_ISR_UPDATE_STEER_ISR_H

#include <cytypes.h>
#include <cyfitter.h>

/* Interrupt Controller API. */
void UPDATE_STEER_ISR_Start(void) ;
void UPDATE_STEER_ISR_StartEx(cyisraddress address) ;
void UPDATE_STEER_ISR_Stop(void) ;

CY_ISR_PROTO(UPDATE_STEER_ISR_Interrupt);

void UPDATE_STEER_ISR_SetVector(cyisraddress address) ;
cyisraddress UPDATE_STEER_ISR_GetVector(void) ;

void UPDATE_STEER_ISR_SetPriority(uint8 priority) ;
uint8 UPDATE_STEER_ISR_GetPriority(void) ;

void UPDATE_STEER_ISR_Enable(void) ;
uint8 UPDATE_STEER_ISR_GetState(void) ;
void UPDATE_STEER_ISR_Disable(void) ;

void UPDATE_STEER_ISR_SetPending(void) ;
void UPDATE_STEER_ISR_ClearPending(void) ;


/* Interrupt Controller Constants */

/* Address of the INTC.VECT[x] register that contains the Address of the UPDATE_STEER_ISR ISR. */
#define UPDATE_STEER_ISR_INTC_VECTOR            ((reg16 *) UPDATE_STEER_ISR__INTC_VECT)

/* Address of the UPDATE_STEER_ISR ISR priority. */
#define UPDATE_STEER_ISR_INTC_PRIOR             ((reg8 *) UPDATE_STEER_ISR__INTC_PRIOR_REG)

/* Priority of the UPDATE_STEER_ISR interrupt. */
#define UPDATE_STEER_ISR_INTC_PRIOR_NUMBER      UPDATE_STEER_ISR__INTC_PRIOR_NUM

/* Address of the INTC.SET_EN[x] byte to bit enable UPDATE_STEER_ISR interrupt. */
#define UPDATE_STEER_ISR_INTC_SET_EN            ((reg8 *) UPDATE_STEER_ISR__INTC_SET_EN_REG)

/* Address of the INTC.CLR_EN[x] register to bit clear the UPDATE_STEER_ISR interrupt. */
#define UPDATE_STEER_ISR_INTC_CLR_EN            ((reg8 *) UPDATE_STEER_ISR__INTC_CLR_EN_REG)

/* Address of the INTC.SET_PD[x] register to set the UPDATE_STEER_ISR interrupt state to pending. */
#define UPDATE_STEER_ISR_INTC_SET_PD            ((reg8 *) UPDATE_STEER_ISR__INTC_SET_PD_REG)

/* Address of the INTC.CLR_PD[x] register to clear the UPDATE_STEER_ISR interrupt. */
#define UPDATE_STEER_ISR_INTC_CLR_PD            ((reg8 *) UPDATE_STEER_ISR__INTC_CLR_PD_REG)



#endif /* CY_ISR_UPDATE_STEER_ISR_H */


/* [] END OF FILE */
