yichengsun/Room-Mapping-Vehicle/PSOC Microprocessor Code/Car.cydsn/codegentemp/LCD.h

/*******************************************************************************
* File Name: LCD.h
* Version 2.10
*
* Description:
*  This header file contains registers and constants associated with the
*  Character LCD component.
*
* Note:
*
********************************************************************************
* Copyright 2008-2014, Cypress Semiconductor Corporation.  All rights reserved.
* You may use this file only in accordance with the license, terms, conditions,
* disclaimers, and limitations in the end user license agreement accompanying
* the software package with which this file was provided.
*******************************************************************************/

#if !defined(CY_CHARLCD_LCD_H)
#define CY_CHARLCD_LCD_H

#include "cytypes.h"
#include "cyfitter.h"


/***************************************
*   Conditional Compilation Parameters
***************************************/

#define LCD_CONVERSION_ROUTINES     (1u)
#define LCD_CUSTOM_CHAR_SET         (0u)

/* Custom character set types */
#define LCD_NONE                     (0u)    /* No Custom Fonts      */
#define LCD_HORIZONTAL_BG            (1u)    /* Horizontal Bar Graph */
#define LCD_VERTICAL_BG              (2u)    /* Vertical Bar Graph   */
#define LCD_USER_DEFINED             (3u)    /* User Defined Fonts   */


/***************************************
*     Data Struct Definitions
***************************************/

/* Sleep Mode API Support */
typedef struct
{
    uint8 enableState;
} LCD_BACKUP_STRUCT;


/***************************************
*        Function Prototypes
***************************************/

void LCD_Init(void) ;
void LCD_Enable(void) ;
void LCD_Start(void) ;
void LCD_Stop(void) ;
void LCD_WriteControl(uint8 cByte) ;
void LCD_WriteData(uint8 dByte) ;
void LCD_PrintString(char8 const string[]) ;
void LCD_Position(uint8 row, uint8 column) ;
void LCD_PutChar(char8 character) ;
void LCD_IsReady(void) ;
void LCD_SaveConfig(void) ;
void LCD_RestoreConfig(void) ;
void LCD_Sleep(void) ;
void LCD_Wakeup(void) ;

#if((LCD_CUSTOM_CHAR_SET == LCD_VERTICAL_BG) || \
                (LCD_CUSTOM_CHAR_SET == LCD_HORIZONTAL_BG))

    void  LCD_LoadCustomFonts(uint8 const customData[])
                        ;

    void  LCD_DrawHorizontalBG(uint8 row, uint8 column, uint8 maxCharacters, uint8 value)
                         ;

    void LCD_DrawVerticalBG(uint8 row, uint8 column, uint8 maxCharacters, uint8 value)
                        ;

#endif /* ((LCD_CUSTOM_CHAR_SET == LCD_VERTICAL_BG) */

#if(LCD_CUSTOM_CHAR_SET == LCD_USER_DEFINED)

    void LCD_LoadCustomFonts(uint8 const customData[])
                            ;

#endif /* ((LCD_CUSTOM_CHAR_SET == LCD_USER_DEFINED) */

#if(LCD_CONVERSION_ROUTINES == 1u)

    /* ASCII Conversion Routines */
    void LCD_PrintInt8(uint8 value) ;
    void LCD_PrintInt16(uint16 value) ;
    void LCD_PrintInt32(uint32 value) ;
    void LCD_PrintNumber(uint16 value) ; 
    void LCD_PrintU32Number(uint32 value) ;
    
#endif /* LCD_CONVERSION_ROUTINES == 1u */

/* Clear Macro */
#define LCD_ClearDisplay() LCD_WriteControl(LCD_CLEAR_DISPLAY)

/* Off Macro */
#define LCD_DisplayOff() LCD_WriteControl(LCD_DISPLAY_CURSOR_OFF)

/* On Macro */
#define LCD_DisplayOn() LCD_WriteControl(LCD_DISPLAY_ON_CURSOR_OFF)

#define LCD_PrintNumber(value) LCD_PrintU32Number((uint16) (value))


/***************************************
*           Global Variables
***************************************/

extern uint8 LCD_initVar;
extern uint8 LCD_enableState;
extern uint8 const CYCODE LCD_customFonts[64u];


/***************************************
*           API Constants
***************************************/

/* Full Byte Commands Sent as Two Nibbles */
#define LCD_DISPLAY_8_BIT_INIT       (0x03u)
#define LCD_DISPLAY_4_BIT_INIT       (0x02u)
#define LCD_DISPLAY_CURSOR_OFF       (0x08u)
#define LCD_CLEAR_DISPLAY            (0x01u)
#define LCD_CURSOR_AUTO_INCR_ON      (0x06u)
#define LCD_DISPLAY_CURSOR_ON        (0x0Eu)
#define LCD_DISPLAY_2_LINES_5x10     (0x2Cu)
#define LCD_DISPLAY_ON_CURSOR_OFF    (0x0Cu)

#define LCD_RESET_CURSOR_POSITION    (0x03u)
#define LCD_CURSOR_WINK              (0x0Du)
#define LCD_CURSOR_BLINK             (0x0Fu)
#define LCD_CURSOR_SH_LEFT           (0x10u)
#define LCD_CURSOR_SH_RIGHT          (0x14u)
#define LCD_DISPLAY_SCRL_LEFT        (0x18u)
#define LCD_DISPLAY_SCRL_RIGHT       (0x1Eu)
#define LCD_CURSOR_HOME              (0x02u)
#define LCD_CURSOR_LEFT              (0x04u)
#define LCD_CURSOR_RIGHT             (0x06u)

/* Point to Character Generator Ram 0 */
#define LCD_CGRAM_0                  (0x40u)

/* Point to Display Data Ram 0 */
#define LCD_DDRAM_0                  (0x80u)

/* LCD Characteristics */
#define LCD_CHARACTER_WIDTH          (0x05u)
#define LCD_CHARACTER_HEIGHT         (0x08u)

#if(LCD_CONVERSION_ROUTINES == 1u)
    #define LCD_NUMBER_OF_REMAINDERS_U32 (0x0Au)
    #define LCD_TEN                      (0x0Au)
    #define LCD_8_BIT_SHIFT              (8u)
    #define LCD_32_BIT_SHIFT             (32u)
    #define LCD_ZERO_CHAR_ASCII          (48u)
#endif /* LCD_CONVERSION_ROUTINES == 1u */

/* Nibble Offset and Mask */
#define LCD_NIBBLE_SHIFT             (0x04u)
#define LCD_NIBBLE_MASK              (0x0Fu)

/* LCD Module Address Constants */
#define LCD_ROW_0_START              (0x80u)
#define LCD_ROW_1_START              (0xC0u)
#define LCD_ROW_2_START              (0x94u)
#define LCD_ROW_3_START              (0xD4u)

/* Custom Character References */
#define LCD_CUSTOM_0                 (0x00u)
#define LCD_CUSTOM_1                 (0x01u)
#define LCD_CUSTOM_2                 (0x02u)
#define LCD_CUSTOM_3                 (0x03u)
#define LCD_CUSTOM_4                 (0x04u)
#define LCD_CUSTOM_5                 (0x05u)
#define LCD_CUSTOM_6                 (0x06u)
#define LCD_CUSTOM_7                 (0x07u)

/* Other constants */
#define LCD_BYTE_UPPER_NIBBLE_SHIFT  (0x04u)
#define LCD_BYTE_LOWER_NIBBLE_MASK   (0x0Fu)
#define LCD_U16_UPPER_BYTE_SHIFT     (0x08u)
#define LCD_U16_LOWER_BYTE_MASK      (0xFFu)
#define LCD_CUSTOM_CHAR_SET_LEN      (0x40u)

#define LCD_LONGEST_CMD_US           (0x651u)
#define LCD_WAIT_CYCLE               (0x10u)
#define LCD_READY_DELAY              ((LCD_LONGEST_CMD_US * 4u)/(LCD_WAIT_CYCLE))


/***************************************
*             Registers
***************************************/

/* Device specific registers */
#if (CY_PSOC4)

    #define LCD_PORT_DR_REG           (*(reg32 *) LCD_LCDPort__DR)  /* Data Output Register */
    #define LCD_PORT_DR_PTR           ( (reg32 *) LCD_LCDPort__DR)
    #define LCD_PORT_PS_REG           (*(reg32 *) LCD_LCDPort__PS)  /* Pin State Register */
    #define LCD_PORT_PS_PTR           ( (reg32 *) LCD_LCDPort__PS)
    
    #define LCD_PORT_PC_REG           (*(reg32 *) LCD_LCDPort__PC)
    #define LCD_PORT_PC_PTR           (*(reg32 *) LCD_LCDPort__PC)
    
#else

    #define LCD_PORT_DR_REG           (*(reg8 *) LCD_LCDPort__DR)  /* Data Output Register */
    #define LCD_PORT_DR_PTR           ( (reg8 *) LCD_LCDPort__DR)
    #define LCD_PORT_PS_REG           (*(reg8 *) LCD_LCDPort__PS)  /* Pin State Register */
    #define LCD_PORT_PS_PTR           ( (reg8 *) LCD_LCDPort__PS)

    #define LCD_PORT_DM0_REG          (*(reg8 *) LCD_LCDPort__DM0) /* Port Drive Mode 0 */
    #define LCD_PORT_DM0_PTR          ( (reg8 *) LCD_LCDPort__DM0)
    #define LCD_PORT_DM1_REG          (*(reg8 *) LCD_LCDPort__DM1) /* Port Drive Mode 1 */
    #define LCD_PORT_DM1_PTR          ( (reg8 *) LCD_LCDPort__DM1)
    #define LCD_PORT_DM2_REG          (*(reg8 *) LCD_LCDPort__DM2) /* Port Drive Mode 2 */
    #define LCD_PORT_DM2_PTR          ( (reg8 *) LCD_LCDPort__DM2)

#endif /* CY_PSOC4 */


/***************************************
*       Register Constants
***************************************/

/* SHIFT must be 1 or 0 */
#if (0 == LCD_LCDPort__SHIFT)
    #define LCD_PORT_SHIFT               (0x00u)
#else
    #define LCD_PORT_SHIFT               (0x01u)
#endif /* (0 == LCD_LCDPort__SHIFT) */

#define LCD_PORT_MASK                ((uint8) (LCD_LCDPort__MASK))

#if (CY_PSOC4)

    #define LCD_DM_PIN_STEP              (3u)
    /* Hi-Z Digital is defined by the value of "001b" and this should be set for
    * four data pins, in this way we get - 0x00000249. A similar Strong drive
    * is defined with "110b" so we get 0x00000DB6.
    */
    #define LCD_HIGH_Z_DATA_DM           ((0x00000249ul) << (LCD_PORT_SHIFT *\
                                                                          LCD_DM_PIN_STEP))
    #define LCD_STRONG_DATA_DM           ((0x00000DB6ul) << (LCD_PORT_SHIFT *\
                                                                          LCD_DM_PIN_STEP))
    #define LCD_DATA_PINS_MASK           (0x00000FFFul)
    #define LCD_DM_DATA_MASK             ((uint32) (LCD_DATA_PINS_MASK << \
                                                      (LCD_PORT_SHIFT * LCD_DM_PIN_STEP)))

#else

    /* Drive Mode register values for High Z */
    #define LCD_HIGH_Z_DM0               (0xFFu)
    #define LCD_HIGH_Z_DM1               (0x00u)
    #define LCD_HIGH_Z_DM2               (0x00u)

    /* Drive Mode register values for High Z Analog */
    #define LCD_HIGH_Z_A_DM0             (0x00u)
    #define LCD_HIGH_Z_A_DM1             (0x00u)
    #define LCD_HIGH_Z_A_DM2             (0x00u)

    /* Drive Mode register values for Strong */
    #define LCD_STRONG_DM0               (0x00u)
    #define LCD_STRONG_DM1               (0xFFu)
    #define LCD_STRONG_DM2               (0xFFu)

#endif /* CY_PSOC4 */

/* Pin Masks */
#define LCD_RS                     ((uint8) \
                                                (((uint8) 0x20u) << LCD_LCDPort__SHIFT))
#define LCD_RW                     ((uint8) \
                                                (((uint8) 0x40u) << LCD_LCDPort__SHIFT))
#define LCD_E                      ((uint8) \
                                                (((uint8) 0x10u) << LCD_LCDPort__SHIFT))
#define LCD_READY_BIT              ((uint8) \
                                                (((uint8) 0x08u) << LCD_LCDPort__SHIFT))
#define LCD_DATA_MASK              ((uint8) \
                                                (((uint8) 0x0Fu) << LCD_LCDPort__SHIFT))

/* These names are obsolete and will be removed in future revisions */
#define LCD_PORT_DR                  LCD_PORT_DR_REG
#define LCD_PORT_PS                  LCD_PORT_PS_REG
#define LCD_PORT_DM0                 LCD_PORT_DM0_REG
#define LCD_PORT_DM1                 LCD_PORT_DM1_REG
#define LCD_PORT_DM2                 LCD_PORT_DM2_REG


/***************************************
*       Obsolete function names
***************************************/
#if(LCD_CONVERSION_ROUTINES == 1u)
    /* This function names are obsolete and will be removed in future 
    * revisions of the component.
    */
    #define LCD_PrintDecUint16(x)   LCD_PrintNumber(x)  
    #define LCD_PrintHexUint8(x)    LCD_PrintInt8(x)
    #define LCD_PrintHexUint16(x)   LCD_PrintInt16(x)        

#endif /* LCD_CONVERSION_ROUTINES == 1u */

#endif /* CY_CHARLCD_LCD_H */


/* [] END OF FILE */
