yichengsun/Room-Mapping-Vehicle/PSOC Microprocessor Code/Car.cydsn/codegentemp/LINE_COUNTER.h

/*******************************************************************************
* File Name: LINE_COUNTER.h  
* Version 2.40
*
*  Description:
*   Contains the function prototypes and constants available to the counter
*   user module.
*
*   Note:
*    None
*
********************************************************************************
* Copyright 2008-2012, Cypress Semiconductor Corporation.  All rights reserved.
* You may use this file only in accordance with the license, terms, conditions, 
* disclaimers, and limitations in the end user license agreement accompanying 
* the software package with which this file was provided.
********************************************************************************/
    
#if !defined(CY_COUNTER_LINE_COUNTER_H)
#define CY_COUNTER_LINE_COUNTER_H

#include "cytypes.h"
#include "cyfitter.h"
#include "CyLib.h" /* For CyEnterCriticalSection() and CyExitCriticalSection() functions */

extern uint8 LINE_COUNTER_initVar;

/* Check to see if required defines such as CY_PSOC5LP are available */
/* They are defined starting with cy_boot v3.0 */
#if !defined (CY_PSOC5LP)
    #error Component Counter_v2_40 requires cy_boot v3.0 or later
#endif /* (CY_ PSOC5LP) */


/**************************************
*           Parameter Defaults        
**************************************/

#define LINE_COUNTER_Resolution            32u
#define LINE_COUNTER_UsingFixedFunction    0u
#define LINE_COUNTER_ControlRegRemoved     0u
#define LINE_COUNTER_COMPARE_MODE_SOFTWARE 0u
#define LINE_COUNTER_CAPTURE_MODE_SOFTWARE 0u
#define LINE_COUNTER_RunModeUsed           0u


/***************************************
*       Type defines
***************************************/


/**************************************************************************
 * Sleep Mode API Support
 * Backup structure for Sleep Wake up operations
 *************************************************************************/
typedef struct
{
    uint8 CounterEnableState; 
    uint32 CounterUdb;         /* Current Counter Value */

    #if (CY_UDB_V0)
        uint32 CounterPeriod;  /* Counter Period Value */
        uint32 CompareValue;   /* Counter Compare Value */           
        uint8 InterruptMaskValue;                   /* Counter Interrupt Mask Value */
    #endif /* (CY_UDB_V0) */

    #if (!LINE_COUNTER_ControlRegRemoved)
        uint8 CounterControlRegister;               /* Counter Control Register */
    #endif /* (!LINE_COUNTER_ControlRegRemoved) */

}LINE_COUNTER_backupStruct;


/**************************************
 *  Function Prototypes
 *************************************/
void    LINE_COUNTER_Start(void) ;
void    LINE_COUNTER_Stop(void) ;
void    LINE_COUNTER_SetInterruptMode(uint8 interruptsMask) ;
uint8   LINE_COUNTER_ReadStatusRegister(void) ;
#define LINE_COUNTER_GetInterruptSource() LINE_COUNTER_ReadStatusRegister()
#if(!LINE_COUNTER_ControlRegRemoved)
    uint8   LINE_COUNTER_ReadControlRegister(void) ;
    void    LINE_COUNTER_WriteControlRegister(uint8 control) \
        ;
#endif /* (!LINE_COUNTER_ControlRegRemoved) */
#if (!(LINE_COUNTER_UsingFixedFunction && (CY_PSOC5A)))
    void    LINE_COUNTER_WriteCounter(uint32 counter) \
            ; 
#endif /* (!(LINE_COUNTER_UsingFixedFunction && (CY_PSOC5A))) */
uint32  LINE_COUNTER_ReadCounter(void) ;
uint32  LINE_COUNTER_ReadCapture(void) ;
void    LINE_COUNTER_WritePeriod(uint32 period) \
    ;
uint32  LINE_COUNTER_ReadPeriod( void ) ;
#if (!LINE_COUNTER_UsingFixedFunction)
    void    LINE_COUNTER_WriteCompare(uint32 compare) \
        ;
    uint32  LINE_COUNTER_ReadCompare( void ) \
        ;
#endif /* (!LINE_COUNTER_UsingFixedFunction) */

#if (LINE_COUNTER_COMPARE_MODE_SOFTWARE)
    void    LINE_COUNTER_SetCompareMode(uint8 compareMode) ;
#endif /* (LINE_COUNTER_COMPARE_MODE_SOFTWARE) */
#if (LINE_COUNTER_CAPTURE_MODE_SOFTWARE)
    void    LINE_COUNTER_SetCaptureMode(uint8 captureMode) ;
#endif /* (LINE_COUNTER_CAPTURE_MODE_SOFTWARE) */
void LINE_COUNTER_ClearFIFO(void)     ;
void LINE_COUNTER_Init(void)          ;
void LINE_COUNTER_Enable(void)        ;
void LINE_COUNTER_SaveConfig(void)    ;
void LINE_COUNTER_RestoreConfig(void) ;
void LINE_COUNTER_Sleep(void)         ;
void LINE_COUNTER_Wakeup(void)        ;


/***************************************
*   Enumerated Types and Parameters
***************************************/

/* Enumerated Type B_Counter__CompareModes, Used in Compare Mode retained for backward compatibility of tests*/
#define LINE_COUNTER__B_COUNTER__LESS_THAN 1
#define LINE_COUNTER__B_COUNTER__LESS_THAN_OR_EQUAL 2
#define LINE_COUNTER__B_COUNTER__EQUAL 0
#define LINE_COUNTER__B_COUNTER__GREATER_THAN 3
#define LINE_COUNTER__B_COUNTER__GREATER_THAN_OR_EQUAL 4
#define LINE_COUNTER__B_COUNTER__SOFTWARE 5

/* Enumerated Type Counter_CompareModes */
#define LINE_COUNTER_CMP_MODE_LT 1u
#define LINE_COUNTER_CMP_MODE_LTE 2u
#define LINE_COUNTER_CMP_MODE_EQ 0u
#define LINE_COUNTER_CMP_MODE_GT 3u
#define LINE_COUNTER_CMP_MODE_GTE 4u
#define LINE_COUNTER_CMP_MODE_SOFTWARE_CONTROLLED 5u

/* Enumerated Type B_Counter__CaptureModes, Used in Capture Mode retained for backward compatibility of tests*/
#define LINE_COUNTER__B_COUNTER__NONE 0
#define LINE_COUNTER__B_COUNTER__RISING_EDGE 1
#define LINE_COUNTER__B_COUNTER__FALLING_EDGE 2
#define LINE_COUNTER__B_COUNTER__EITHER_EDGE 3
#define LINE_COUNTER__B_COUNTER__SOFTWARE_CONTROL 4

/* Enumerated Type Counter_CompareModes */
#define LINE_COUNTER_CAP_MODE_NONE 0u
#define LINE_COUNTER_CAP_MODE_RISE 1u
#define LINE_COUNTER_CAP_MODE_FALL 2u
#define LINE_COUNTER_CAP_MODE_BOTH 3u
#define LINE_COUNTER_CAP_MODE_SOFTWARE_CONTROLLED 4u


/***************************************
 *  Initialization Values
 **************************************/
#define LINE_COUNTER_CAPTURE_MODE_CONF       0u
#define LINE_COUNTER_INIT_PERIOD_VALUE       4294967295u
#define LINE_COUNTER_INIT_COUNTER_VALUE      0u
#if (LINE_COUNTER_UsingFixedFunction)
#define LINE_COUNTER_INIT_INTERRUPTS_MASK    ((uint8)((uint8)0u << LINE_COUNTER_STATUS_ZERO_INT_EN_MASK_SHIFT))
#else
#define LINE_COUNTER_INIT_COMPARE_VALUE      25u
#define LINE_COUNTER_INIT_INTERRUPTS_MASK ((uint8)((uint8)0u << LINE_COUNTER_STATUS_ZERO_INT_EN_MASK_SHIFT) | \
        ((uint8)((uint8)0u << LINE_COUNTER_STATUS_CAPTURE_INT_EN_MASK_SHIFT)) | \
        ((uint8)((uint8)0u << LINE_COUNTER_STATUS_CMP_INT_EN_MASK_SHIFT)) | \
        ((uint8)((uint8)0u << LINE_COUNTER_STATUS_OVERFLOW_INT_EN_MASK_SHIFT)) | \
        ((uint8)((uint8)0u << LINE_COUNTER_STATUS_UNDERFLOW_INT_EN_MASK_SHIFT)))
#define LINE_COUNTER_DEFAULT_COMPARE_MODE    0u

#if( 0 != LINE_COUNTER_CAPTURE_MODE_CONF)
    #define LINE_COUNTER_DEFAULT_CAPTURE_MODE    ((uint8)((uint8)0u << LINE_COUNTER_CTRL_CAPMODE0_SHIFT))
#else    
    #define LINE_COUNTER_DEFAULT_CAPTURE_MODE    (0u )
#endif /* ( 0 != LINE_COUNTER_CAPTURE_MODE_CONF) */

#endif /* (LINE_COUNTER_UsingFixedFunction) */


/**************************************
 *  Registers
 *************************************/
#if (LINE_COUNTER_UsingFixedFunction)
    #define LINE_COUNTER_STATICCOUNT_LSB     (*(reg16 *) LINE_COUNTER_CounterHW__CAP0 )
    #define LINE_COUNTER_STATICCOUNT_LSB_PTR ( (reg16 *) LINE_COUNTER_CounterHW__CAP0 )
    #define LINE_COUNTER_PERIOD_LSB          (*(reg16 *) LINE_COUNTER_CounterHW__PER0 )
    #define LINE_COUNTER_PERIOD_LSB_PTR      ( (reg16 *) LINE_COUNTER_CounterHW__PER0 )
    /* MODE must be set to 1 to set the compare value */
    #define LINE_COUNTER_COMPARE_LSB         (*(reg16 *) LINE_COUNTER_CounterHW__CNT_CMP0 )
    #define LINE_COUNTER_COMPARE_LSB_PTR     ( (reg16 *) LINE_COUNTER_CounterHW__CNT_CMP0 )
    /* MODE must be set to 0 to get the count */
    #define LINE_COUNTER_COUNTER_LSB         (*(reg16 *) LINE_COUNTER_CounterHW__CNT_CMP0 )
    #define LINE_COUNTER_COUNTER_LSB_PTR     ( (reg16 *) LINE_COUNTER_CounterHW__CNT_CMP0 )
    #define LINE_COUNTER_RT1                 (*(reg8 *) LINE_COUNTER_CounterHW__RT1)
    #define LINE_COUNTER_RT1_PTR             ( (reg8 *) LINE_COUNTER_CounterHW__RT1)
#else
    
    #if (LINE_COUNTER_Resolution <= 8u) /* 8-bit Counter */
    
        #define LINE_COUNTER_STATICCOUNT_LSB     (*(reg8 *) \
            LINE_COUNTER_CounterUDB_sC32_counterdp_u0__F0_REG )
        #define LINE_COUNTER_STATICCOUNT_LSB_PTR ( (reg8 *) \
            LINE_COUNTER_CounterUDB_sC32_counterdp_u0__F0_REG )
        #define LINE_COUNTER_PERIOD_LSB          (*(reg8 *) \
            LINE_COUNTER_CounterUDB_sC32_counterdp_u0__D0_REG )
        #define LINE_COUNTER_PERIOD_LSB_PTR      ( (reg8 *) \
            LINE_COUNTER_CounterUDB_sC32_counterdp_u0__D0_REG )
        #define LINE_COUNTER_COMPARE_LSB         (*(reg8 *) \
            LINE_COUNTER_CounterUDB_sC32_counterdp_u0__D1_REG )
        #define LINE_COUNTER_COMPARE_LSB_PTR     ( (reg8 *) \
            LINE_COUNTER_CounterUDB_sC32_counterdp_u0__D1_REG )
        #define LINE_COUNTER_COUNTER_LSB         (*(reg8 *) \
            LINE_COUNTER_CounterUDB_sC32_counterdp_u0__A0_REG )  
        #define LINE_COUNTER_COUNTER_LSB_PTR     ( (reg8 *)\
            LINE_COUNTER_CounterUDB_sC32_counterdp_u0__A0_REG )
    
    #elif(LINE_COUNTER_Resolution <= 16u) /* 16-bit Counter */
        #if(CY_PSOC3) /* 8-bit address space */ 
            #define LINE_COUNTER_STATICCOUNT_LSB     (*(reg16 *) \
                LINE_COUNTER_CounterUDB_sC32_counterdp_u0__F0_REG )
            #define LINE_COUNTER_STATICCOUNT_LSB_PTR ( (reg16 *) \
                LINE_COUNTER_CounterUDB_sC32_counterdp_u0__F0_REG )
            #define LINE_COUNTER_PERIOD_LSB          (*(reg16 *) \
                LINE_COUNTER_CounterUDB_sC32_counterdp_u0__D0_REG )
            #define LINE_COUNTER_PERIOD_LSB_PTR      ( (reg16 *) \
                LINE_COUNTER_CounterUDB_sC32_counterdp_u0__D0_REG )
            #define LINE_COUNTER_COMPARE_LSB         (*(reg16 *) \
                LINE_COUNTER_CounterUDB_sC32_counterdp_u0__D1_REG )
            #define LINE_COUNTER_COMPARE_LSB_PTR     ( (reg16 *) \
                LINE_COUNTER_CounterUDB_sC32_counterdp_u0__D1_REG )
            #define LINE_COUNTER_COUNTER_LSB         (*(reg16 *) \
                LINE_COUNTER_CounterUDB_sC32_counterdp_u0__A0_REG )  
            #define LINE_COUNTER_COUNTER_LSB_PTR     ( (reg16 *)\
                LINE_COUNTER_CounterUDB_sC32_counterdp_u0__A0_REG )
        #else /* 16-bit address space */
            #define LINE_COUNTER_STATICCOUNT_LSB     (*(reg16 *) \
                LINE_COUNTER_CounterUDB_sC32_counterdp_u0__16BIT_F0_REG )
            #define LINE_COUNTER_STATICCOUNT_LSB_PTR ( (reg16 *) \
                LINE_COUNTER_CounterUDB_sC32_counterdp_u0__16BIT_F0_REG )
            #define LINE_COUNTER_PERIOD_LSB          (*(reg16 *) \
                LINE_COUNTER_CounterUDB_sC32_counterdp_u0__16BIT_D0_REG )
            #define LINE_COUNTER_PERIOD_LSB_PTR      ( (reg16 *) \
                LINE_COUNTER_CounterUDB_sC32_counterdp_u0__16BIT_D0_REG )
            #define LINE_COUNTER_COMPARE_LSB         (*(reg16 *) \
                LINE_COUNTER_CounterUDB_sC32_counterdp_u0__16BIT_D1_REG )
            #define LINE_COUNTER_COMPARE_LSB_PTR     ( (reg16 *) \
                LINE_COUNTER_CounterUDB_sC32_counterdp_u0__16BIT_D1_REG )
            #define LINE_COUNTER_COUNTER_LSB         (*(reg16 *) \
                LINE_COUNTER_CounterUDB_sC32_counterdp_u0__16BIT_A0_REG )  
            #define LINE_COUNTER_COUNTER_LSB_PTR     ( (reg16 *)\
                LINE_COUNTER_CounterUDB_sC32_counterdp_u0__16BIT_A0_REG )
        #endif /* CY_PSOC3 */   
    #elif(LINE_COUNTER_Resolution <= 24u) /* 24-bit Counter */
        
        #define LINE_COUNTER_STATICCOUNT_LSB     (*(reg32 *) \
            LINE_COUNTER_CounterUDB_sC32_counterdp_u0__F0_REG )
        #define LINE_COUNTER_STATICCOUNT_LSB_PTR ( (reg32 *) \
            LINE_COUNTER_CounterUDB_sC32_counterdp_u0__F0_REG )
        #define LINE_COUNTER_PERIOD_LSB          (*(reg32 *) \
            LINE_COUNTER_CounterUDB_sC32_counterdp_u0__D0_REG )
        #define LINE_COUNTER_PERIOD_LSB_PTR      ( (reg32 *) \
            LINE_COUNTER_CounterUDB_sC32_counterdp_u0__D0_REG )
        #define LINE_COUNTER_COMPARE_LSB         (*(reg32 *) \
            LINE_COUNTER_CounterUDB_sC32_counterdp_u0__D1_REG )
        #define LINE_COUNTER_COMPARE_LSB_PTR     ( (reg32 *) \
            LINE_COUNTER_CounterUDB_sC32_counterdp_u0__D1_REG )
        #define LINE_COUNTER_COUNTER_LSB         (*(reg32 *) \
            LINE_COUNTER_CounterUDB_sC32_counterdp_u0__A0_REG )  
        #define LINE_COUNTER_COUNTER_LSB_PTR     ( (reg32 *)\
            LINE_COUNTER_CounterUDB_sC32_counterdp_u0__A0_REG )
    
    #else /* 32-bit Counter */
        #if(CY_PSOC3 || CY_PSOC5) /* 8-bit address space */
            #define LINE_COUNTER_STATICCOUNT_LSB     (*(reg32 *) \
                LINE_COUNTER_CounterUDB_sC32_counterdp_u0__F0_REG )
            #define LINE_COUNTER_STATICCOUNT_LSB_PTR ( (reg32 *) \
                LINE_COUNTER_CounterUDB_sC32_counterdp_u0__F0_REG )
            #define LINE_COUNTER_PERIOD_LSB          (*(reg32 *) \
                LINE_COUNTER_CounterUDB_sC32_counterdp_u0__D0_REG )
            #define LINE_COUNTER_PERIOD_LSB_PTR      ( (reg32 *) \
                LINE_COUNTER_CounterUDB_sC32_counterdp_u0__D0_REG )
            #define LINE_COUNTER_COMPARE_LSB         (*(reg32 *) \
                LINE_COUNTER_CounterUDB_sC32_counterdp_u0__D1_REG )
            #define LINE_COUNTER_COMPARE_LSB_PTR     ( (reg32 *) \
                LINE_COUNTER_CounterUDB_sC32_counterdp_u0__D1_REG )
            #define LINE_COUNTER_COUNTER_LSB         (*(reg32 *) \
                LINE_COUNTER_CounterUDB_sC32_counterdp_u0__A0_REG )  
            #define LINE_COUNTER_COUNTER_LSB_PTR     ( (reg32 *)\
                LINE_COUNTER_CounterUDB_sC32_counterdp_u0__A0_REG )
        #else /* 32-bit address space */
            #define LINE_COUNTER_STATICCOUNT_LSB     (*(reg32 *) \
                LINE_COUNTER_CounterUDB_sC32_counterdp_u0__32BIT_F0_REG )
            #define LINE_COUNTER_STATICCOUNT_LSB_PTR ( (reg32 *) \
                LINE_COUNTER_CounterUDB_sC32_counterdp_u0__32BIT_F0_REG )
            #define LINE_COUNTER_PERIOD_LSB          (*(reg32 *) \
                LINE_COUNTER_CounterUDB_sC32_counterdp_u0__32BIT_D0_REG )
            #define LINE_COUNTER_PERIOD_LSB_PTR      ( (reg32 *) \
                LINE_COUNTER_CounterUDB_sC32_counterdp_u0__32BIT_D0_REG )
            #define LINE_COUNTER_COMPARE_LSB         (*(reg32 *) \
                LINE_COUNTER_CounterUDB_sC32_counterdp_u0__32BIT_D1_REG )
            #define LINE_COUNTER_COMPARE_LSB_PTR     ( (reg32 *) \
                LINE_COUNTER_CounterUDB_sC32_counterdp_u0__32BIT_D1_REG )
            #define LINE_COUNTER_COUNTER_LSB         (*(reg32 *) \
                LINE_COUNTER_CounterUDB_sC32_counterdp_u0__32BIT_A0_REG )  
            #define LINE_COUNTER_COUNTER_LSB_PTR     ( (reg32 *)\
                LINE_COUNTER_CounterUDB_sC32_counterdp_u0__32BIT_A0_REG )
        #endif /* CY_PSOC3 || CY_PSOC5 */   
    #endif

	#define LINE_COUNTER_COUNTER_LSB_PTR_8BIT     ( (reg8 *)\
                LINE_COUNTER_CounterUDB_sC32_counterdp_u0__A0_REG )
				
    #define LINE_COUNTER_AUX_CONTROLDP0 \
        (*(reg8 *) LINE_COUNTER_CounterUDB_sC32_counterdp_u0__DP_AUX_CTL_REG)
    
    #define LINE_COUNTER_AUX_CONTROLDP0_PTR \
        ( (reg8 *) LINE_COUNTER_CounterUDB_sC32_counterdp_u0__DP_AUX_CTL_REG)
    
    #if (LINE_COUNTER_Resolution == 16 || LINE_COUNTER_Resolution == 24 || LINE_COUNTER_Resolution == 32)
       #define LINE_COUNTER_AUX_CONTROLDP1 \
           (*(reg8 *) LINE_COUNTER_CounterUDB_sC32_counterdp_u1__DP_AUX_CTL_REG)
       #define LINE_COUNTER_AUX_CONTROLDP1_PTR \
           ( (reg8 *) LINE_COUNTER_CounterUDB_sC32_counterdp_u1__DP_AUX_CTL_REG)
    #endif /* (LINE_COUNTER_Resolution == 16 || LINE_COUNTER_Resolution == 24 || LINE_COUNTER_Resolution == 32) */
    
    #if (LINE_COUNTER_Resolution == 24 || LINE_COUNTER_Resolution == 32)
       #define LINE_COUNTER_AUX_CONTROLDP2 \
           (*(reg8 *) LINE_COUNTER_CounterUDB_sC32_counterdp_u2__DP_AUX_CTL_REG)
       #define LINE_COUNTER_AUX_CONTROLDP2_PTR \
           ( (reg8 *) LINE_COUNTER_CounterUDB_sC32_counterdp_u2__DP_AUX_CTL_REG)
    #endif /* (LINE_COUNTER_Resolution == 24 || LINE_COUNTER_Resolution == 32) */
    
    #if (LINE_COUNTER_Resolution == 32)
       #define LINE_COUNTER_AUX_CONTROLDP3 \
           (*(reg8 *) LINE_COUNTER_CounterUDB_sC32_counterdp_u3__DP_AUX_CTL_REG)
       #define LINE_COUNTER_AUX_CONTROLDP3_PTR \
           ( (reg8 *) LINE_COUNTER_CounterUDB_sC32_counterdp_u3__DP_AUX_CTL_REG)
    #endif /* (LINE_COUNTER_Resolution == 32) */

#endif  /* (LINE_COUNTER_UsingFixedFunction) */

#if (LINE_COUNTER_UsingFixedFunction)
    #define LINE_COUNTER_STATUS         (*(reg8 *) LINE_COUNTER_CounterHW__SR0 )
    /* In Fixed Function Block Status and Mask are the same register */
    #define LINE_COUNTER_STATUS_MASK             (*(reg8 *) LINE_COUNTER_CounterHW__SR0 )
    #define LINE_COUNTER_STATUS_MASK_PTR         ( (reg8 *) LINE_COUNTER_CounterHW__SR0 )
    #define LINE_COUNTER_CONTROL                 (*(reg8 *) LINE_COUNTER_CounterHW__CFG0)
    #define LINE_COUNTER_CONTROL_PTR             ( (reg8 *) LINE_COUNTER_CounterHW__CFG0)
    #define LINE_COUNTER_CONTROL2                (*(reg8 *) LINE_COUNTER_CounterHW__CFG1)
    #define LINE_COUNTER_CONTROL2_PTR            ( (reg8 *) LINE_COUNTER_CounterHW__CFG1)
    #if (CY_PSOC3 || CY_PSOC5LP)
        #define LINE_COUNTER_CONTROL3       (*(reg8 *) LINE_COUNTER_CounterHW__CFG2)
        #define LINE_COUNTER_CONTROL3_PTR   ( (reg8 *) LINE_COUNTER_CounterHW__CFG2)
    #endif /* (CY_PSOC3 || CY_PSOC5LP) */
    #define LINE_COUNTER_GLOBAL_ENABLE           (*(reg8 *) LINE_COUNTER_CounterHW__PM_ACT_CFG)
    #define LINE_COUNTER_GLOBAL_ENABLE_PTR       ( (reg8 *) LINE_COUNTER_CounterHW__PM_ACT_CFG)
    #define LINE_COUNTER_GLOBAL_STBY_ENABLE      (*(reg8 *) LINE_COUNTER_CounterHW__PM_STBY_CFG)
    #define LINE_COUNTER_GLOBAL_STBY_ENABLE_PTR  ( (reg8 *) LINE_COUNTER_CounterHW__PM_STBY_CFG)
    

    /********************************
    *    Constants
    ********************************/

    /* Fixed Function Block Chosen */
    #define LINE_COUNTER_BLOCK_EN_MASK          LINE_COUNTER_CounterHW__PM_ACT_MSK
    #define LINE_COUNTER_BLOCK_STBY_EN_MASK     LINE_COUNTER_CounterHW__PM_STBY_MSK 
    
    /* Control Register Bit Locations */    
    /* As defined in Register Map, part of TMRX_CFG0 register */
    #define LINE_COUNTER_CTRL_ENABLE_SHIFT      0x00u
    #define LINE_COUNTER_ONESHOT_SHIFT          0x02u
    /* Control Register Bit Masks */
    #define LINE_COUNTER_CTRL_ENABLE            ((uint8)((uint8)0x01u << LINE_COUNTER_CTRL_ENABLE_SHIFT))         
    #define LINE_COUNTER_ONESHOT                ((uint8)((uint8)0x01u << LINE_COUNTER_ONESHOT_SHIFT))

    /* Control2 Register Bit Masks */
    /* Set the mask for run mode */
    #if (CY_PSOC5A)
        /* Use CFG1 Mode bits to set run mode */
        #define LINE_COUNTER_CTRL_MODE_SHIFT        0x01u    
        #define LINE_COUNTER_CTRL_MODE_MASK         ((uint8)((uint8)0x07u << LINE_COUNTER_CTRL_MODE_SHIFT))
    #endif /* (CY_PSOC5A) */
    #if (CY_PSOC3 || CY_PSOC5LP)
        /* Use CFG2 Mode bits to set run mode */
        #define LINE_COUNTER_CTRL_MODE_SHIFT        0x00u    
        #define LINE_COUNTER_CTRL_MODE_MASK         ((uint8)((uint8)0x03u << LINE_COUNTER_CTRL_MODE_SHIFT))
    #endif /* (CY_PSOC3 || CY_PSOC5LP) */
    /* Set the mask for interrupt (raw/status register) */
    #define LINE_COUNTER_CTRL2_IRQ_SEL_SHIFT     0x00u
    #define LINE_COUNTER_CTRL2_IRQ_SEL          ((uint8)((uint8)0x01u << LINE_COUNTER_CTRL2_IRQ_SEL_SHIFT))     
    
    /* Status Register Bit Locations */
    #define LINE_COUNTER_STATUS_ZERO_SHIFT      0x07u  /* As defined in Register Map, part of TMRX_SR0 register */ 

    /* Status Register Interrupt Enable Bit Locations */
    #define LINE_COUNTER_STATUS_ZERO_INT_EN_MASK_SHIFT      (LINE_COUNTER_STATUS_ZERO_SHIFT - 0x04u)

    /* Status Register Bit Masks */                           
    #define LINE_COUNTER_STATUS_ZERO            ((uint8)((uint8)0x01u << LINE_COUNTER_STATUS_ZERO_SHIFT))

    /* Status Register Interrupt Bit Masks*/
    #define LINE_COUNTER_STATUS_ZERO_INT_EN_MASK       ((uint8)((uint8)LINE_COUNTER_STATUS_ZERO >> 0x04u))
    
    /*RT1 Synch Constants: Applicable for PSoC3 and PSoC5LP */
    #define LINE_COUNTER_RT1_SHIFT            0x04u
    #define LINE_COUNTER_RT1_MASK             ((uint8)((uint8)0x03u << LINE_COUNTER_RT1_SHIFT))  /* Sync TC and CMP bit masks */
    #define LINE_COUNTER_SYNC                 ((uint8)((uint8)0x03u << LINE_COUNTER_RT1_SHIFT))
    #define LINE_COUNTER_SYNCDSI_SHIFT        0x00u
    #define LINE_COUNTER_SYNCDSI_MASK         ((uint8)((uint8)0x0Fu << LINE_COUNTER_SYNCDSI_SHIFT)) /* Sync all DSI inputs */
    #define LINE_COUNTER_SYNCDSI_EN           ((uint8)((uint8)0x0Fu << LINE_COUNTER_SYNCDSI_SHIFT)) /* Sync all DSI inputs */
    
#else /* !LINE_COUNTER_UsingFixedFunction */
    #define LINE_COUNTER_STATUS               (* (reg8 *) LINE_COUNTER_CounterUDB_sSTSReg_rstSts_stsreg__STATUS_REG )
    #define LINE_COUNTER_STATUS_PTR           (  (reg8 *) LINE_COUNTER_CounterUDB_sSTSReg_rstSts_stsreg__STATUS_REG )
    #define LINE_COUNTER_STATUS_MASK          (* (reg8 *) LINE_COUNTER_CounterUDB_sSTSReg_rstSts_stsreg__MASK_REG )
    #define LINE_COUNTER_STATUS_MASK_PTR      (  (reg8 *) LINE_COUNTER_CounterUDB_sSTSReg_rstSts_stsreg__MASK_REG )
    #define LINE_COUNTER_STATUS_AUX_CTRL      (*(reg8 *) LINE_COUNTER_CounterUDB_sSTSReg_rstSts_stsreg__STATUS_AUX_CTL_REG)
    #define LINE_COUNTER_STATUS_AUX_CTRL_PTR  ( (reg8 *) LINE_COUNTER_CounterUDB_sSTSReg_rstSts_stsreg__STATUS_AUX_CTL_REG)
    #define LINE_COUNTER_CONTROL              (* (reg8 *) LINE_COUNTER_CounterUDB_sCTRLReg_SyncCtl_ctrlreg__CONTROL_REG )
    #define LINE_COUNTER_CONTROL_PTR          (  (reg8 *) LINE_COUNTER_CounterUDB_sCTRLReg_SyncCtl_ctrlreg__CONTROL_REG )


    /********************************
    *    Constants
    ********************************/
    /* Control Register Bit Locations */
    #define LINE_COUNTER_CTRL_CAPMODE0_SHIFT    0x03u       /* As defined by Verilog Implementation */
    #define LINE_COUNTER_CTRL_RESET_SHIFT       0x06u       /* As defined by Verilog Implementation */
    #define LINE_COUNTER_CTRL_ENABLE_SHIFT      0x07u       /* As defined by Verilog Implementation */
    /* Control Register Bit Masks */
    #define LINE_COUNTER_CTRL_CMPMODE_MASK      0x07u 
    #define LINE_COUNTER_CTRL_CAPMODE_MASK      0x03u  
    #define LINE_COUNTER_CTRL_RESET             ((uint8)((uint8)0x01u << LINE_COUNTER_CTRL_RESET_SHIFT))  
    #define LINE_COUNTER_CTRL_ENABLE            ((uint8)((uint8)0x01u << LINE_COUNTER_CTRL_ENABLE_SHIFT)) 

    /* Status Register Bit Locations */
    #define LINE_COUNTER_STATUS_CMP_SHIFT       0x00u       /* As defined by Verilog Implementation */
    #define LINE_COUNTER_STATUS_ZERO_SHIFT      0x01u       /* As defined by Verilog Implementation */
    #define LINE_COUNTER_STATUS_OVERFLOW_SHIFT  0x02u       /* As defined by Verilog Implementation */
    #define LINE_COUNTER_STATUS_UNDERFLOW_SHIFT 0x03u       /* As defined by Verilog Implementation */
    #define LINE_COUNTER_STATUS_CAPTURE_SHIFT   0x04u       /* As defined by Verilog Implementation */
    #define LINE_COUNTER_STATUS_FIFOFULL_SHIFT  0x05u       /* As defined by Verilog Implementation */
    #define LINE_COUNTER_STATUS_FIFONEMP_SHIFT  0x06u       /* As defined by Verilog Implementation */
    /* Status Register Interrupt Enable Bit Locations - UDB Status Interrupt Mask match Status Bit Locations*/
    #define LINE_COUNTER_STATUS_CMP_INT_EN_MASK_SHIFT       LINE_COUNTER_STATUS_CMP_SHIFT       
    #define LINE_COUNTER_STATUS_ZERO_INT_EN_MASK_SHIFT      LINE_COUNTER_STATUS_ZERO_SHIFT      
    #define LINE_COUNTER_STATUS_OVERFLOW_INT_EN_MASK_SHIFT  LINE_COUNTER_STATUS_OVERFLOW_SHIFT  
    #define LINE_COUNTER_STATUS_UNDERFLOW_INT_EN_MASK_SHIFT LINE_COUNTER_STATUS_UNDERFLOW_SHIFT 
    #define LINE_COUNTER_STATUS_CAPTURE_INT_EN_MASK_SHIFT   LINE_COUNTER_STATUS_CAPTURE_SHIFT   
    #define LINE_COUNTER_STATUS_FIFOFULL_INT_EN_MASK_SHIFT  LINE_COUNTER_STATUS_FIFOFULL_SHIFT  
    #define LINE_COUNTER_STATUS_FIFONEMP_INT_EN_MASK_SHIFT  LINE_COUNTER_STATUS_FIFONEMP_SHIFT  
    /* Status Register Bit Masks */                
    #define LINE_COUNTER_STATUS_CMP             ((uint8)((uint8)0x01u << LINE_COUNTER_STATUS_CMP_SHIFT))  
    #define LINE_COUNTER_STATUS_ZERO            ((uint8)((uint8)0x01u << LINE_COUNTER_STATUS_ZERO_SHIFT)) 
    #define LINE_COUNTER_STATUS_OVERFLOW        ((uint8)((uint8)0x01u << LINE_COUNTER_STATUS_OVERFLOW_SHIFT)) 
    #define LINE_COUNTER_STATUS_UNDERFLOW       ((uint8)((uint8)0x01u << LINE_COUNTER_STATUS_UNDERFLOW_SHIFT)) 
    #define LINE_COUNTER_STATUS_CAPTURE         ((uint8)((uint8)0x01u << LINE_COUNTER_STATUS_CAPTURE_SHIFT)) 
    #define LINE_COUNTER_STATUS_FIFOFULL        ((uint8)((uint8)0x01u << LINE_COUNTER_STATUS_FIFOFULL_SHIFT))
    #define LINE_COUNTER_STATUS_FIFONEMP        ((uint8)((uint8)0x01u << LINE_COUNTER_STATUS_FIFONEMP_SHIFT))
    /* Status Register Interrupt Bit Masks  - UDB Status Interrupt Mask match Status Bit Locations */
    #define LINE_COUNTER_STATUS_CMP_INT_EN_MASK            LINE_COUNTER_STATUS_CMP                    
    #define LINE_COUNTER_STATUS_ZERO_INT_EN_MASK           LINE_COUNTER_STATUS_ZERO            
    #define LINE_COUNTER_STATUS_OVERFLOW_INT_EN_MASK       LINE_COUNTER_STATUS_OVERFLOW        
    #define LINE_COUNTER_STATUS_UNDERFLOW_INT_EN_MASK      LINE_COUNTER_STATUS_UNDERFLOW       
    #define LINE_COUNTER_STATUS_CAPTURE_INT_EN_MASK        LINE_COUNTER_STATUS_CAPTURE         
    #define LINE_COUNTER_STATUS_FIFOFULL_INT_EN_MASK       LINE_COUNTER_STATUS_FIFOFULL        
    #define LINE_COUNTER_STATUS_FIFONEMP_INT_EN_MASK       LINE_COUNTER_STATUS_FIFONEMP         
    

    /* StatusI Interrupt Enable bit Location in the Auxilliary Control Register */
    #define LINE_COUNTER_STATUS_ACTL_INT_EN     0x10u /* As defined for the ACTL Register */
    
    /* Datapath Auxillary Control Register definitions */
    #define LINE_COUNTER_AUX_CTRL_FIFO0_CLR         0x01u   /* As defined by Register map */
    #define LINE_COUNTER_AUX_CTRL_FIFO1_CLR         0x02u   /* As defined by Register map */
    #define LINE_COUNTER_AUX_CTRL_FIFO0_LVL         0x04u   /* As defined by Register map */
    #define LINE_COUNTER_AUX_CTRL_FIFO1_LVL         0x08u   /* As defined by Register map */
    #define LINE_COUNTER_STATUS_ACTL_INT_EN_MASK    0x10u   /* As defined for the ACTL Register */
    
#endif /* LINE_COUNTER_UsingFixedFunction */

#endif  /* CY_COUNTER_LINE_COUNTER_H */


/* [] END OF FILE */
