yichengsun/Room-Mapping-Vehicle/PSOC Microprocessor Code/Car.cydsn/codegentemp/LCD.c

/*******************************************************************************
* File Name: LCD.c
* Version 2.10
*
* Description:
*  This file provides source code for the Character LCD component's API.
*
* Note:
*
********************************************************************************
* Copyright 2008-2014, Cypress Semiconductor Corporation.  All rights reserved.
* You may use this file only in accordance with the license, terms, conditions,
* disclaimers, and limitations in the end user license agreement accompanying
* the software package with which this file was provided.
*******************************************************************************/

#include "CyLib.h"
#include "LCD.h"


static void LCD_WrDatNib(uint8 nibble) ;
static void LCD_WrCntrlNib(uint8 nibble) ;

/* Stores state of component. Indicates whether component is or not
* in enable state.
*/
uint8 LCD_enableState = 0u;

uint8 LCD_initVar = 0u;


/*******************************************************************************
* Function Name: LCD_Init
********************************************************************************
*
* Summary:
*  Performs initialization required for the components normal work.
*  This function initializes the LCD hardware module as follows:
*        Enables a 4-bit interface
*        Clears the display
*        Enables the auto cursor increment
*        Resets the cursor to start position
*  Also, it loads a custom character set to the LCD if it was defined in the customizer.
*
* Parameters:
*  None.
*
* Return:
*  None.
*
* Reentrant:
*  No.
*
*******************************************************************************/
void LCD_Init(void) 
{
    /* INIT CODE */
    CyDelay(40u);                                                        /* Delay 40 ms */
    LCD_WrCntrlNib(LCD_DISPLAY_8_BIT_INIT);    /* Selects 8-bit mode */
    CyDelay(5u);                                                         /* Delay 5 ms */
    LCD_WrCntrlNib(LCD_DISPLAY_8_BIT_INIT);    /* Selects 8-bit mode */
    CyDelay(15u);                                                        /* Delay 15 ms */
    LCD_WrCntrlNib(LCD_DISPLAY_8_BIT_INIT);    /* Selects 8-bit mode */
    CyDelay(1u);                                                         /* Delay 1 ms */
    LCD_WrCntrlNib(LCD_DISPLAY_4_BIT_INIT);    /* Selects 4-bit mode */
    CyDelay(5u);                                                         /* Delay 5 ms */

    LCD_WriteControl(LCD_CURSOR_AUTO_INCR_ON);    /* Incr Cursor After Writes */
    LCD_WriteControl(LCD_DISPLAY_CURSOR_ON);      /* Turn Display, Cursor ON */
    LCD_WriteControl(LCD_DISPLAY_2_LINES_5x10);   /* 2 Lines by 5x10 Characters */
    LCD_WriteControl(LCD_DISPLAY_CURSOR_OFF);     /* Turn Display, Cursor OFF */
    LCD_WriteControl(LCD_CLEAR_DISPLAY);          /* Clear LCD Screen */
    LCD_WriteControl(LCD_DISPLAY_ON_CURSOR_OFF);  /* Turn Display ON, Cursor OFF */
    LCD_WriteControl(LCD_RESET_CURSOR_POSITION);  /* Set Cursor to 0,0 */
    CyDelay(5u);

    #if(LCD_CUSTOM_CHAR_SET != LCD_NONE)
        LCD_LoadCustomFonts(LCD_customFonts);
    #endif /* LCD_CUSTOM_CHAR_SET != LCD_NONE */
}


/*******************************************************************************
* Function Name: LCD_Enable
********************************************************************************
*
* Summary:
*  Turns on the display.
*
* Parameters:
*  None.
*
* Return:
*  None.
*
* Reentrant:
*  No.
*
* Theory:
*  This function has no effect when it is called the first time as
*  LCD_Init() turns on the LCD.
*
*******************************************************************************/
void LCD_Enable(void) 
{
    LCD_DisplayOn();
    LCD_enableState = 1u;
}


/*******************************************************************************
* Function Name: LCD_Start
********************************************************************************
*
* Summary:
*  Performs initialization required for the components normal work.
*  This function initializes the LCD hardware module as follows:
*        Enables 4-bit interface
*        Clears the display
*        Enables auto cursor increment
*        Resets the cursor to start position
*  Also, it loads a custom character set to the LCD if it was defined in the customizer.
*  If it was not the first call in this project, then it just turns on the
*  display
*
*
* Parameters:
*  LCD_initVar - global variable.
*
* Return:
*  LCD_initVar - global variable.
*
* Reentrant:
*  No.
*
*******************************************************************************/
void LCD_Start(void) 
{
    /* If not initialized, perform initialization */
    if(LCD_initVar == 0u)
    {
        LCD_Init();
        LCD_initVar = 1u;
    }

    /* Turn on the LCD */
    LCD_Enable();
}


/*******************************************************************************
* Function Name: LCD_Stop
********************************************************************************
*
* Summary:
*  Turns off the display of the LCD screen.
*
* Parameters:
*  None.
*
* Return:
*  None.
*
* Reentrant:
*  No.
*
*******************************************************************************/
void LCD_Stop(void) 
{
    /* Calls LCD Off Macro */
    LCD_DisplayOff();
    LCD_enableState = 0u;
}


/*******************************************************************************
*  Function Name: LCD_Position
********************************************************************************
*
* Summary:
*  Moves the active cursor location to a point specified by the input arguments
*
* Parameters:
*  row:    Specific row of LCD module to be written
*  column: Column of LCD module to be written
*
* Return:
*  None.
*
* Note:
*  This only applies for LCD displays that use the 2X40 address mode.
*  In this case Row 2 starts with a 0x28 offset from Row 1.
*  When there are more than 2 rows, each row must be fewer than 20 characters.
*
*******************************************************************************/
void LCD_Position(uint8 row, uint8 column) 
{
    switch (row)
    {
        case (uint8)0:
            LCD_WriteControl(LCD_ROW_0_START + column);
            break;
        case (uint8) 1:
            LCD_WriteControl(LCD_ROW_1_START + column);
            break;
        case (uint8) 2:
            LCD_WriteControl(LCD_ROW_2_START + column);
            break;
        case (uint8) 3:
            LCD_WriteControl(LCD_ROW_3_START + column);
            break;
        default:
            /* if default case is hit, invalid row argument was passed.*/
            break;
    }
}


/*******************************************************************************
* Function Name: LCD_PrintString
********************************************************************************
*
* Summary:
*  Writes a zero terminated string to the LCD.
*
* Parameters:
*  string: Pointer to head of char8 array to be written to the LCD module
*
* Return:
*  None.
*
*******************************************************************************/
void LCD_PrintString(char8 const string[]) 
{
    uint8 indexU8 = 1u;
    char8 current = *string;

    /* Until null is reached, print next character */
    while((char8) '\0' != current)
    {
        LCD_WriteData((uint8)current);
        current = string[indexU8];
        indexU8++;
    }
}


/*******************************************************************************
*  Function Name: LCD_PutChar
********************************************************************************
*
* Summary:
*  Writes a single character to the current cursor position of the LCD module.
*  Custom character names (_CUSTOM_0 through
*  _CUSTOM_7) are acceptable as inputs.
*
* Parameters:
*  character: Character to be written to LCD
*
* Return:
*  None.
*
*******************************************************************************/
void LCD_PutChar(char8 character) 
{
    LCD_WriteData((uint8)character);
}


/*******************************************************************************
*  Function Name: LCD_WriteData
********************************************************************************
*
* Summary:
*  Writes a data byte to the LCD module's Data Display RAM.
*
* Parameters:
*  dByte: Byte to be written to the LCD module
*
* Return:
*  None.
*
*******************************************************************************/
void LCD_WriteData(uint8 dByte) 
{
    uint8 nibble;

    LCD_IsReady();
    nibble = dByte >> LCD_NIBBLE_SHIFT;

    /* Write high nibble */
    LCD_WrDatNib(nibble);

    nibble = dByte & LCD_NIBBLE_MASK;
    /* Write low nibble */
    LCD_WrDatNib(nibble);
}


/*******************************************************************************
*  Function Name: LCD_WriteControl
********************************************************************************
*
* Summary:
*  Writes a command byte to the LCD module.
*
* Parameters:
*  cByte:  The byte to be written to theLCD module
* 
* Return:
*  None.
*
*******************************************************************************/
void LCD_WriteControl(uint8 cByte) 
{
    uint8 nibble;

    LCD_IsReady();

    nibble = cByte >> LCD_NIBBLE_SHIFT;
    
    /* WrCntrlNib(High Nibble) */
    LCD_WrCntrlNib(nibble);
    nibble = cByte & LCD_NIBBLE_MASK;

    /* WrCntrlNib(Low Nibble) */
    LCD_WrCntrlNib(nibble);
}


/*******************************************************************************
* Function Name: LCD_IsReady
********************************************************************************
*
* Summary:
*  Polls the LCD until the ready bit is set or a timeout occurs.
*
* Parameters:
*  None.
*
* Return:
*  None.
*
* Note:
*  Changes the pins to High-Z.
*
*******************************************************************************/
void LCD_IsReady(void) 
{
    uint8 value;
    uint32 timeout;
    timeout = LCD_READY_DELAY;

    /* Clear LCD port*/
    LCD_PORT_DR_REG &= ((uint8)(~LCD_PORT_MASK));

    /* PSoC4 has a little different from PSoC3/5 port/pin organization for setting Drive Modes.
  
    */
    #if (CY_PSOC4)
        
        /* Mask off data pins to clear old values out */
        value = LCD_PORT_PC_REG & ((uint32) (~ LCD_DM_DATA_MASK));
        /* Load in high Z values for data pins, others unchanged */
        LCD_PORT_PC_REG = value | LCD_HIGH_Z_DATA_DM;

    #else
    
        /* Change Port to High-Z Status on data pins */

        /* Mask off data pins to clear old values out */
        value = LCD_PORT_DM0_REG & ((uint8)(~LCD_DATA_MASK));
        /* Load in high Z values for data pins, others unchanged */
        LCD_PORT_DM0_REG = value | (LCD_HIGH_Z_DM0 & LCD_DATA_MASK);

        /* Mask off data pins to clear old values out */
        value = LCD_PORT_DM1_REG & ((uint8)(~LCD_DATA_MASK));
        /* Load in high Z values for data pins, others unchanged */
        LCD_PORT_DM1_REG = value;

        /* Mask off data pins to clear old values out */
        value = LCD_PORT_DM2_REG & ((uint8)(~LCD_DATA_MASK));
        /* Load in high Z values for data pins, others unchanged */
        LCD_PORT_DM2_REG = value;
    
    #endif /* CY_PSOC4 */
    
    /* Make sure RS is low */
    LCD_PORT_DR_REG &= ((uint8)(~LCD_RS));

    /* Set R/W high to read */
    LCD_PORT_DR_REG |= LCD_RW;

    do
    {
        /* 40 ns delay required before rising Enable and 500ns between neighbour Enables */
        CyDelayUs(0u);

        /* Set E high */
        LCD_PORT_DR_REG |= LCD_E;

        /* 360 ns delay setup time for data pins */
        CyDelayUs(1u);

        /* Get port state */
        value = LCD_PORT_PS_REG;

        /* Set enable low */
        LCD_PORT_DR_REG &= ((uint8)(~LCD_E));

        /* This gives true delay between disabling Enable bit and polling Ready bit */
        CyDelayUs(0u);

        /* Extract ready bit */
        value &= LCD_READY_BIT;

        /* Set E high as we in 4-bit interface we need extra operation */
        LCD_PORT_DR_REG |= LCD_E;

        /* 360 ns delay setup time for data pins */
        CyDelayUs(1u);

        /* Set enable low */
        LCD_PORT_DR_REG &= ((uint8)(~LCD_E));

        /* If LCD is not ready make a delay */
        if (value == 0u)
        {
            CyDelayUs(10u);
        }

        /* Repeat until bit 4 is not zero or until timeout. */
        timeout--;

    } while ((value != 0u) && (timeout > 0u));

    /* Set R/W low to write */
    LCD_PORT_DR_REG &= ((uint8)(~LCD_RW));

    /* Clear LCD port*/
    LCD_PORT_DR_REG &= ((uint8)(~LCD_PORT_MASK));

    #if (CY_PSOC4)
        
        /* Mask off data pins to clear old values out */
        value = LCD_PORT_PC_REG & ((uint32)(~ LCD_DM_DATA_MASK));
        /* Load in high Z values for data pins, others unchanged */
        LCD_PORT_PC_REG = value | LCD_STRONG_DATA_DM;

    #else

        /* Change Port to Output (Strong) on data pins */
        /* Mask off data pins to clear high z values out. Configure data pins 
        * to Strong Drive, others unchanged.
        */
        LCD_PORT_DM0_REG &= ((uint8)(~LCD_DATA_MASK));
        /* Mask off data pins to clear high z values out */
        value = LCD_PORT_DM1_REG & ((uint8)(~LCD_DATA_MASK));
        /* Configure data pins to Strong Drive, others unchanged */
        LCD_PORT_DM1_REG = value | (LCD_STRONG_DM1 & LCD_DATA_MASK);

        /* Mask off data pins to clear high z values out */
        value = LCD_PORT_DM2_REG & ((uint8)(~LCD_DATA_MASK));
        /* Configure data pins to Strong Drive, others unchanged */
        LCD_PORT_DM2_REG = value | (LCD_STRONG_DM2 & LCD_DATA_MASK);
    
    #endif /* CY_PSOC4 */
}


/*******************************************************************************
*  Function Name: LCD_WrDatNib
********************************************************************************
*
* Summary:
*  Writes a data nibble to the LCD module.
*
* Parameters:
*  nibble:  Byte containing nibble in the least significant nibble to be
*           written to the LCD module.
*
* Return:
*  None.
*
*******************************************************************************/
static void LCD_WrDatNib(uint8 nibble) 
{
    /* RS should be low to select data register */
    LCD_PORT_DR_REG |= LCD_RS;
    /* Reset RW for write operation */
    LCD_PORT_DR_REG &= ((uint8)(~LCD_RW));

    /* Guaranteed delay between Setting RS and RW and setting E bits */
    CyDelayUs(0u);
    
    /* Clear data pins */
    LCD_PORT_DR_REG &= ((uint8)(~LCD_DATA_MASK));

    /* Write data, bring E high */
    #if(0u != LCD_PORT_SHIFT) /* MISRA forbids shift by 0 so need to handle that */
        LCD_PORT_DR_REG |= 
            (LCD_E | ((uint8)(((uint8) nibble) << LCD_PORT_SHIFT)));
    #else
        LCD_PORT_DR_REG |= (LCD_E | nibble);
    #endif /* (0u != LCD_PORT_SHIFT) */

    /* Minimum of 230 ns delay */
    CyDelayUs(1u);

    LCD_PORT_DR_REG &= ((uint8)(~LCD_E));
}


/*******************************************************************************
*  Function Name: LCD_WrCntrlNib
********************************************************************************
*
* Summary:
*  Writes a control nibble to the LCD module.
*
* Parameters:
*  nibble: The byte containing a nibble in the four least significant bits.????
*
* Return:
*  None.
*
*******************************************************************************/
static void LCD_WrCntrlNib(uint8 nibble) 
{
    /* RS and RW should be low to select instruction register and  write operation respectively */
    LCD_PORT_DR_REG &= ((uint8)(~(LCD_RS | LCD_RW)));

    /* Two following lines of code will give 40ns delay */
    /* Clear data pins */
    LCD_PORT_DR_REG &= ((uint8)(~LCD_DATA_MASK));

    /* Write control data and set enable signal */
    #if(0u != LCD_PORT_SHIFT) /* MISRA forbids shift by 0 so need to handle that */
        LCD_PORT_DR_REG |= 
            (LCD_E | ((uint8)(((uint8) nibble) << LCD_PORT_SHIFT)));
    #else
        LCD_PORT_DR_REG |= (LCD_E | nibble);
    #endif /* (0u != LCD_PORT_SHIFT) */

    /* Minimum of 230 ns delay */
    CyDelayUs(1u);

    LCD_PORT_DR_REG &= ((uint8)(~LCD_E));
}


#if(LCD_CONVERSION_ROUTINES == 1u)

    /*******************************************************************************
    *  Function Name: LCD_PrintInt8
    ********************************************************************************
    *
    * Summary:
    *  Print a byte as two ASCII characters.
    *
    * Parameters:
    *  value: The byte to be printed out as ASCII characters.
    *
    * Return:
    *  None.
    *
    *******************************************************************************/
    void LCD_PrintInt8(uint8 value) 
    {
        static char8 const CYCODE LCD_hex[16u] = "0123456789ABCDEF";
        
        LCD_PutChar((char8) LCD_hex[value >> LCD_BYTE_UPPER_NIBBLE_SHIFT]);
        LCD_PutChar((char8) LCD_hex[value & LCD_BYTE_LOWER_NIBBLE_MASK]);
    }


    /*******************************************************************************
    *  Function Name: LCD_PrintInt16
    ********************************************************************************
    *
    * Summary:
    *  Print a uint16 as four ASCII characters.
    *
    * Parameters:
    *  value: The uint16 to be printed out as ASCII characters.
    *
    * Return:
    *  None.
    *
    *******************************************************************************/
    void LCD_PrintInt16(uint16 value) 
    {
        LCD_PrintInt8((uint8)(value >> LCD_U16_UPPER_BYTE_SHIFT));
        LCD_PrintInt8((uint8)(value & LCD_U16_LOWER_BYTE_MASK));
    }

    
    /*******************************************************************************
    *  Function Name: LCD_PrintInt32
    ********************************************************************************
    *
    * Summary:
    *  Print a uint32 hexadecimal number as eight ASCII characters.
    *
    * Parameters:
    *  value: The uint32 to be printed out as ASCII characters.
    *
    * Return:
    *  None.
    *
    *******************************************************************************/
    void LCD_PrintInt32(uint32 value) 
    {
        uint8 shift = LCD_32_BIT_SHIFT;
        
        while (shift != 0u)
        {
            /* "shift" var is to be subtracted by 8 prior shifting. This implements 
            * shifting by 24, 16, 8 and 0u. 
            */
            shift -= LCD_8_BIT_SHIFT;
            
            /* Print 8 bits of uint32 hex number */
            LCD_PrintInt8((uint8) ((uint32) (value >> shift)));
        }
    }
    
    
    /*******************************************************************************
    *  Function Name: LCD_PrintNumber
    ********************************************************************************
    *
    * Summary:
    *  Print an uint16 value as a left-justified decimal value.
    *
    * Parameters:
    *  value: A 16-bit value to be printed in ASCII characters as a decimal number
    *
    * Return:
    *  None.
    *
    * Note:
    *  This function is implemented as a macro.
    *
    *******************************************************************************/

    
    /*******************************************************************************
    *  Function Name: LCD_PrintU32Number
    ********************************************************************************
    *
    * Summary:
    *  Print an uint32 value as a left-justified decimal value.
    *
    * Parameters:
    *  value: A 32-bit value to be printed in ASCII characters as a decimal number
    *
    * Return:
    *  None.
    *
    *******************************************************************************/
    void LCD_PrintU32Number(uint32 value) 
    {
        uint8 tmpDigit;
        char8 number[LCD_NUMBER_OF_REMAINDERS_U32 + 1u];
        uint8 digIndex = LCD_NUMBER_OF_REMAINDERS_U32;
        
        /* This API will output a decimal number as a string and that string will be 
        * filled from end to start. Set Null termination character first.
        */
        number[digIndex] = (char8) '\0';
        digIndex--;
        
        /* Load these in reverse order */
        while(value >= LCD_TEN)
        {
            /* Extract decimal digit, indexed by 'digIndex', from 'value' and
            * convert it to ASCII character.
            */
            tmpDigit = (uint8) (((uint8) (value % LCD_TEN)) + (uint8) LCD_ZERO_CHAR_ASCII);
            
            /* Temporary variable 'tmpDigit' is used to avoid Violation of MISRA rule 
            * #10.3.
            */
            number[digIndex] = (char8) tmpDigit;
            value /= LCD_TEN;
            digIndex--;
        }
        
        /* Extract last decimal digit 'digIndex', from the 'value' and convert it
        * to ASCII character.
        */
        tmpDigit = (uint8) (((uint8)(value % LCD_TEN)) + (uint8) LCD_ZERO_CHAR_ASCII);
        number[digIndex] = (char8) tmpDigit;

        /* Print out number */
        LCD_PrintString(&number[digIndex]);
    }
    
#endif /* LCD_CONVERSION_ROUTINES == 1u */


/* [] END OF FILE */
