yichengsun/Room-Mapping-Vehicle/PSOC Microprocessor Code/Car.cydsn/codegentemp/DIR_REG.c

/*******************************************************************************
* File Name: DIR_REG.c  
* Version 1.70
*
* Description:
*  This file contains API to enable firmware control of a Control Register.
*
* Note:
*
********************************************************************************
* Copyright 2008-2012, Cypress Semiconductor Corporation.  All rights reserved.
* You may use this file only in accordance with the license, terms, conditions, 
* disclaimers, and limitations in the end user license agreement accompanying 
* the software package with which this file was provided.
*******************************************************************************/

#include "DIR_REG.h"

#if !defined(DIR_REG_Sync_ctrl_reg__REMOVED) /* Check for removal by optimization */

/*******************************************************************************
* Function Name: DIR_REG_Write
********************************************************************************
*
* Summary:
*  Write a byte to the Control Register.
*
* Parameters:
*  control:  The value to be assigned to the Control Register.
*
* Return:
*  None.
*
*******************************************************************************/
void DIR_REG_Write(uint8 control) 
{
    DIR_REG_Control = control;
}


/*******************************************************************************
* Function Name: DIR_REG_Read
********************************************************************************
*
* Summary:
*  Reads the current value assigned to the Control Register.
*
* Parameters:
*  None.
*
* Return:
*  Returns the current value in the Control Register.
*
*******************************************************************************/
uint8 DIR_REG_Read(void) 
{
    return DIR_REG_Control;
}

#endif /* End check for removal by optimization */


/* [] END OF FILE */
