yichengsun/Room-Mapping-Vehicle/(commit log)

2015-02-23 [schematics] added voltage regulator and hall effect
    [car.sch]
2015-02-25 [PSOC] added code for PWM and HE sensor
2015-02-26 [PSOC] added PID code
2015-03-14 updated PSOC code with camera topdesign
    [Car.sdf]
2015-03-14 [psoc] rc pwm servo control code added
    [Car.sdf]
2015-03-14 sorta have reading line sample code
    [Car.sdf]
2015-03-26 changes to measuring output
    [Car.sdf]
2015-03-26 steering PID added
2015-03-26 compiled steering update
    [Car.sdf]
2015-03-26 updated steering PID
    [Car.sdf]
2015-03-26 updated PID code
    [Car.sdf]
2015-03-27 single read steering
    [Car.sdf]
2015-03-27 steering harwdware working now
    [Car.sdf]
2015-03-27 legoo hack it
    [Car.sdf]
2015-03-27 update steering
    [Car.sdf]
2015-03-27 primitive working version
    [Car.sdf]
2015-03-28 Working version
    [Car.sdf]
2015-03-28 working steering
2015-03-29 WORKING STEERING AT 3_5 ft/s
    [Car.sdf]
2015-04-22 updated code and mast laser cut files
    [Car.sdf]
2015-04-30 [arduino] added odometry code
    [Car.sdf]
2015-05-02 psoc code w/ arduino integration
    [Car.sdf]
2015-05-06 arduino code updated
    [Car.sdf]
2015-05-07 arduino code
2015-05-08 working odometrygit add *git add *
2015-05-09 working visualization code
    [Car.sdf]
2015-08-05 organized file directory
    [Car.sdf, car.sch, encoder_hub.stl]
2015-08-06 added image assets
    [car.sch, encoder_hub.stl]
